lemon56789/delta_robot_proj/README.md

# Delta Robot with Virtual Sensing

## 📌 프로젝트 개요
저가형 델타 로봇의 하드웨어 한계를 **가상 센싱 기술**과 **모델 기반 보정**을 통해 극복하는 것을 목표로 한다.

- 저가 모터 + 3D 프린팅 프레임 사용
- 시뮬레이션 기반 디지털 트윈 구축
- 가상 센싱을 통한 정밀도 보정

---

## 🎯 목표
- 시뮬레이션 결과와 실제 로봇 동작을 최대한 일치시키기
- 센서 없이도 높은 위치 정확도 확보
- 저가 하드웨어의 한계 극복

---

## 🧠 핵심 기술
- Delta Robot Inverse Kinematics
- Multibody Dynamics (RecurDyn)
- Structural Analysis (Nastran)
- Simscape 기반 Digital Twin
- Virtual Sensing (AI + Physics Hybrid)

---

## 🧩 시스템 구조
```mermaid
flowchart LR
    A[Target Trajectory] --> B[Controller<br/>Arduino]
    B --> C[Real Robot<br/>Hardware]
    C --> D[Measured Data]
    D --> E[Virtual Sensor<br/>AI Model]
    E --> F[Correction Value]
    F --> G[Feedback to Controller]
    G --> B
```

---

## 🛠️ 사용 툴
- MATLAB / Simulink / Simscape
- RecurDyn
- Nastran
- Arduino
- PyTorch (future optional)
- Unity (optional)
- GitHub

---

## 👥 팀원 역할

| 팀원 | 역할 |
|---|---|
| S | 팀장, 하드웨어 제작/조립, 기획 단계 동역학/진동 분석 |
| L | 시스템 통합, 가상센싱, 데이터 처리/학습 |
| Y | Arduino 제어, 회로 구성/배선, 전원 연결 |
| T | 하드웨어 제작/조립, 기구 설계 |
| N | 하드웨어 제작/조립, 프로파일 주문제작 요청, 기획 단계 구조/응력 해석 |

---

## 📂 폴더 구조

delta-robot-virtual-sensing/
├─ docs/
├─ kinematics/
├─ simulation/
├─ hardware/
├─ cad/
├─ data/
│  └─ vision/
│     └─ raw/
├─ control/
├─ virtual_sensor/
└─ experiments/

---

## 🚀 진행 단계

상세 실행 계획과 현재 우선순위는 `docs/roadmap.md`를 기준으로 관리한다.

```mermaid
flowchart LR
    subgraph A["1. 설계"]
        A0["Status: Planned"]
        A1["[ ] 기구 규격 정의"]
        A2["[ ] 역기구학 수식 정리"]
        A3["[ ] 모터 및 재료 선정"]
    end

    subgraph B["2. 시뮬레이션"]
        B0["Status: Planned"]
        B1["[ ] 구조 해석"]
        B2["[ ] 동역학 해석"]
        B3["[ ] 디지털 트윈 구축"]
    end

    subgraph C["3. 제작"]
        C0["Status: Planned"]
        C1["[ ] 3D 프린팅 및 조립"]
        C2["[ ] 아두이노 제어 구현"]
    end

    subgraph D["4. 가상센싱"]
        D0["Status: Planned"]
        D1["[ ] 데이터 비교 및 학습"]
        D2["[ ] 오차 보정"]
    end

    subgraph E["5. 검증"]
        E0["Status: Planned"]
        E1["[ ] 궤적 오차 분석"]
        E2["[ ] 시스템 신뢰성 평가"]
    end

    A --> B --> C --> D --> E
```

진행 현황은 아래 체크박스로 바로 갱신할 수 있습니다.

- [ ] 1단계 설계 완료
- [ ] 2단계 시뮬레이션 완료
- [ ] 3단계 제작 완료
- [ ] 4단계 가상센싱 완료
- [ ] 5단계 검증 완료

### 1단계: 설계
- 기구 규격 정의
- 역기구학 수식 정리
- 모터 및 재료 선정

### 2단계: 시뮬레이션
- 구조 해석
- 동역학 해석
- 디지털 트윈 구축

### 3단계: 제작
- 3D 프린팅 및 조립
- 아두이노 제어 구현

### 4단계: 가상센싱
- 데이터 비교 및 학습
- 오차 보정

초기 학습 및 검증 단계에서는 외부 비전 기반 `XY ground-truth` 측정계를 사용해 엔드이펙터의 실제 위치 기준값을 확보할 수 있다. 운영 단계에서는 해당 외부 측정계를 제거하고, 모터 각도 실측값과 시뮬레이션 데이터를 활용한 가상센싱 기반 보정만 사용한다.

### 5단계: 검증
- 궤적 오차 분석
- 시스템 신뢰성 평가
