lemon56789/delta_robot_proj/hardware/README.md

# hardware

실물 하드웨어 제작, 배선, BOM, 조립 관련 자료를 관리하는 폴더입니다.
