lemon56789/delta_robot_proj/cad/README.md

# cad

기구 설계용 CAD 모델(STEP/STL 포함)을 관리하는 폴더입니다.
