lemon56789/delta_robot_proj/control/README.md

# control

Arduino 제어 로직과 제어 파라미터를 관리하는 폴더입니다.
