lemon56789/delta_robot_proj/fulltext.md

# Delta Robot Virtual Sensing - Full Context

문서 목적: 외부 AI 모델이 이 리포지토리를 빠르게 이해하고, 분석/코드 지원을 수행할 수 있도록 프로젝트 전반을 한 파일로 요약한다.
갱신일: 2026-06-10

주의: 이 파일은 요약본이다. 상충 시 Source of Truth는 `docs/*` -> `AGENTS.md` -> `README.md` -> 코드 순서를 따른다.

## 1) 프로젝트 개요
이 프로젝트는 저가형 델타 로봇의 하드웨어 한계를 가상 센싱(Virtual Sensing)과 모델 기반 보정으로 보완해 위치 정밀도를 높이는 것을 목표로 한다.

핵심 접근:
- 저가 모터와 3D 프린팅 기반 하드웨어를 사용한다.
- Simscape 중심의 시뮬레이션 경로를 구축한다.
- 실제 로봇 로그, 시뮬레이션 데이터, 외부 ground-truth, AI 기반 가상센서를 연결한다.
- 최종 운영 단계에서는 외부 비전 측정계를 제거하고, 모터 명령/실측 각도/시뮬레이션 데이터 기반 보정만 사용한다.

## 2) 현재 시스템 흐름
기본 시스템 흐름은 아래와 같다.

```text
Target Trajectory
-> Inverse Kinematics
-> Arduino Controller
-> Delta Robot Hardware
-> Measured Data
-> Simulation Data
-> Virtual Sensor
-> Correction
-> Feedback Controller
```

의도:
- 목표 위치를 IK로 `theta*_cmd`로 변환한다.
- 실제 로봇에서 `theta*_meas`와 위치 오차 관련 데이터를 수집한다.
- Simscape 결과와 실제 로그를 시간축 기준으로 정렬한다.
- 가상센서가 위치 오차 또는 보정값을 추정한다.
- 보정값은 현재 정책상 `target_position`에 주입한다.

## 3) 주요 폴더 역할
- `docs/`: 프로젝트 문서, 시스템 설계, 운동학 메모, 비전 측정계 문서, measured data 구조 문서, 로드맵
- `docs/plans/`: 작업 전 승인용 계획서
- `docs/daily_notes/`: 날짜별 변경 기록
- `docs/templates/`: 계획서와 Daily Note 템플릿
- `docs/references/`: 참고 논문 및 외부 자료 보관 경로. SoT나 채택안을 의미하지 않는다.
- `docs/workspace_envelope.md`: 설치 높이와 `XY` 작업공간 관계를 정리한 설계 참고 문서
- `docs/measured_data_structure.md`: real main log, vision raw log, angle-derived measured position, processed merged dataset 구조
- `docs/hardware_experiment_index.md`: 하드웨어 실험 문서 인덱스
- `docs/hardware_experiment_base_config.md`: 하드웨어/제어/전원/비전/로그 공통 설정
- `docs/hardware_experiment_run_*.md`: 커미셔닝, baseline 수집, 보정 비교, 최종 시연용 run protocol
- `kinematics/`: 역기구학/순기구학 구현, 왕복 검증 및 workspace 분석
- `simulation/`: RecurDyn, Nastran, Simscape 기반 시뮬레이션 자산
- `hardware/`: 실물 제작, 배선, BOM, 조립 자료
- `control/`: Arduino 제어 로직 및 파라미터
- `virtual_sensor/`: 가상 센서 학습/추론 코드
- `data/`: 실험/시뮬레이션 원본 및 가공 데이터
- `data/real/raw/`: Run 01/02 main, correction, metadata, serial raw
  artifact 저장 경로
- `data/real/derived/`: angle-derived measured position CSV 저장 경로
- `data/vision/raw/`: 비전 기반 raw ground-truth 로그 저장 기준 경로
- `data/vision/calibration/`: calibration/homography artifact 저장 경로
- `data/simulation/raw/`: Simscape raw output CSV 저장 경로
- `data/processed/`: processed merged dataset 저장 경로
- `cad/`: CAD 모델
- `experiments/`: 실험 계획, 로그, 성능 검증 자료

## 3-A) 팀 역할 요약
- S: 팀장, 하드웨어 제작/조립, 실험 진행 지원, 기획 단계 동역학/진동 분석
- L: 시스템 통합, 가상센싱, 데이터 처리/학습, 비전 기반 측정
- Y: Arduino 제어, 회로 구성/배선, 전원 및 구동계 연결
- T: 하드웨어 제작/조립, 기구 설계, 제작 치수 검토
- N: 하드웨어 제작/조립, 프로파일 주문제작 요청, 기획 단계 구조/응력 해석
- 동역학/진동/구조/응력 해석은 기획 단계 역할로 유지하되, 시간 제약상 실제 주 산출물은 Run 00/Run 01-pre 하드웨어 제작, 조립, 회로/배선, 데이터 파이프라인 검증 중심으로 정리한다.

## 4) 좌표계와 단위
현재 기준 문서: `docs/system_data_flow.md`

기본 정의:
- position unit: `mm`
- angle unit: `deg`
- coordinate frame: `base_frame`
- origin: base center `O`
- `+x`: `B1` 방향에서 반시계 90도 회전한 방향
- `+y`: `O -> B1`의 반대 방향
- `+z`: base에서 바깥으로 나오는 방향
- workspace direction: `-z`
- right-hand rule: 사용

기구 변수:
- `sB`: base 정삼각형 변 길이
- `sP`: platform 정삼각형 변 길이
- `uB`: base 중심에서 꼭짓점까지의 거리
- `uP`: platform 중심에서 꼭짓점까지의 거리
- `wB`: base 중심에서 motor/upper-arm joint 기준점까지의 거리
- `wP`: platform 중심에서 변까지의 거리
- `L`: motor-driven upper arm length
- `l`: parallelogram link length
- `B1`, `B2`, `B3`: 각 motor/base side center
- `P1`, `P2`, `P3`: 각 platform 연결점

현재 nominal geometry parameter:
- `L = 125.0 mm`
- `l = 300.0 mm`
- `wB = 46.0 mm`
- `uP = 27.177 mm`

현재 하드웨어 참고 치수:
- `sB = 199 mm`: base 외곽 정삼각형 변 길이이며 IK/FK 기준값이 아니다.
- `sP = 57.5 mm`: platform 외곽 정삼각형 변 길이이며 IK/FK 기준값이 아니다.
- `H = 285 mm`: base origin/base center O에서 ground plane까지의 설치 높이다.
- 기구학 계산에서는 외곽 치수보다 `wB`, `uP`를 우선한다.

## 5) 데이터 계약과 시간 정책
현재 기준 문서: `docs/system_data_flow.md`, `docs/measured_data_structure.md`

Timestamp:
- field name: `time`
- format: `boot_ms`
- resolution: `ms`
- Arduino와 PC logger가 각각 timestamp를 기록한다.
- 이후 `post-alignment`로 정렬한다.
- 누락 timestamp row는 `invalid`로 표기하고 후처리에서 제외한다.

현재 final processed CSV 고정 컬럼 순서:
1. `time`
2. `target_x`
3. `target_y`
4. `target_z`
5. `theta1_cmd`
6. `theta2_cmd`
7. `theta3_cmd`
8. `theta1_meas`
9. `theta2_meas`
10. `theta3_meas`
11. `sim_x`
12. `sim_y`
13. `sim_z`
14. `error_x`
15. `error_y`
16. `error_z`

중요:
- 기존 초기 예시의 `motor*_cmd`, `motor*_meas` 대신 현재 문서에서는 `theta*_cmd`, `theta*_meas`를 사용한다.
- correction 관련 필드는 `corr_*`가 아니라 `error_*`를 사용한다.
- CSV 구조 변경은 Contract Change로 취급한다.
- 위 16개 컬럼은 raw log가 아니라 학습/평가용 processed merged dataset의 fixed column order다.
- real main log, vision raw log, angle-derived measured position은 별도 raw/auxiliary 계층으로 관리한다.
- contract-compliant `error_*`는 measured data, simulation output, vision data가 post-alignment된 processed merged dataset 단계에서만 생성한다.

Measured data 계층:
- Real main log: `data/real/raw/main_<run_id>.csv`에 `run_id`, `time`, `target_*`, `theta*_cmd`, `theta*_meas`, `valid`를 기록한다.
- Vision raw log: `data/vision/raw/vision_<run_id>.csv`에 `run_id`, `vision_time`, `vision_x`, `vision_y`, `marker_detected`, `frame_id`, `valid`를 기록한다.
- Simscape raw output: `data/simulation/raw/simscape_<run_id>.csv`에 `time`, `sim_x`, `sim_y`, `sim_z`를 기록한다.
- Angle-derived measured position: `data/real/derived/measured_position_<run_id>.csv`에 `theta*_meas` 기반 FK 또는 estimator로 `measured_x_est`, `measured_y_est`, `measured_z_est`를 생성한다.
- Processed merged dataset: `data/processed/merged_<run_id>.csv`에 real main log, Simscape output, vision raw log, angle-derived measured position을 정렬해 16개 final CSV 컬럼을 만든다.

`error_*` 생성 기준:
- `error_x = measured_x_vision - sim_x`
- `error_y = measured_y_vision - sim_y`
- `error_z = measured_z_est - sim_z`
- `error_x/y`는 vision 기반 XY ground-truth에서 생성한다.
- `error_z`는 angle-derived estimate 기반이므로 외부 ground-truth 기반 3D 성능 수치로 해석하지 않는다.

## 6) 인터페이스 계약
IK:
- input order: `target_x`, `target_y`, `target_z`
- output order: `theta1_cmd`, `theta2_cmd`, `theta3_cmd`
- position 기준: `base_frame`, `mm`
- angle 기준: `deg`
- fail behavior: `reject`

Simulation:
- primary source: `Simscape`
- input: `target_x`, `target_y`, `target_z`
- output: `sim_x`, `sim_y`, `sim_z`
- `RecurDyn` 결과는 추후 cross-check용 secondary reference가 될 수 있다.

Alignment:
- 기준 clock: `PC logger`
- resampling: `linear interpolation`
- delay compensation: `post-alignment`
- 현재 fake pipeline 기준 `Simscape` 비교에서는 provisional `1 sample = 20 ms` lag 보정을 사용한다.
- Run 01-pre preprocessing에서는 vision 로그 시작 시각을 main 첫 timestamp에 맞추는 provisional relative-time alignment를 사용했다.
- `invalid` row는 alignment와 비교에서 제외한다.

Correction:
- correction target: `target_position`
- correction fields: `error_x`, `error_y`, `error_z`
- correction unavailable fallback: uncorrected target position 사용
- SoT 의미는 `measured_position - sim_position`이며, 현재 `Simscape` CSV의 `target_position - sim_position` 값은 임시 diagnostic으로만 해석한다.
- `error_*`는 raw Simscape export에서 확정하지 않고, measured data 구조가 정렬된 processed merged dataset 단계에서 생성한다.
- 현재 Run 02 실행값은 XY gain `0.25`, XY vector norm clamp `2 mm`,
  Z correction off다.
- 현재 제어 분류는 encoder feedback closed loop가 아니라
  `theta*_meas=command_echo_no_encoder` 기반 PC-side feedforward
  correction이다.

## 7) 비전 기반 Ground-Truth 측정계
현재 기준 문서: `docs/vision_tracking.md`

역할:
- 운영 센서가 아니다.
- 학습 및 검증 단계에서만 사용하는 외부 `XY ground-truth` 측정계다.
- 최종 운영 경로는 `motor command + measured motor angle + simulation data + virtual sensing` 기준을 유지한다.

구성:
- top-view USB webcam
- ArUco marker 우선
- OpenCV 기반 marker detection
- calibration, lens distortion correction, planar homography 적용
- 좌표 결과는 `base_frame` 기준 `mm`로 변환

범위:
- 단일 top-view webcam 기준으로 `XY` 위치를 측정한다.
- `Z` 위치는 직접 ground-truth로 제공하지 않는다.
- 비전 로그는 메인 CSV 필수 컬럼에 직접 편입하지 않는다.
- timestamp 기준 후처리로 메인 로그와 병합한다.

비전 로그 저장 기준:
- 기본 경로: `data/vision/raw/`
- 최소 파일명 규칙: `vision_<run_id>.csv`
- 최소 필드: `run_id`, `vision_time`, `vision_x`, `vision_y`, `marker_detected`, `frame_id`, `valid`
- 선택 필드: `marker_id`, `reprojection_error`, `confidence`, `video_file`

Run 00에서 vision system은 marker 검출뿐 아니라 좌표계 방향 확인에도 사용한다.
- 정지 상태에서 `vision_x/y`가 `base_frame` 기준 mm 좌표로 안정적으로 기록되는지 확인한다.
- 작은 +x/+y 수동 이동을 만들었을 때 vision 좌표 증가 방향이 SoT 좌표계와 일치해야 한다.
- 초기 motor direction/zeroing 확인 단계에서 marker loss는 hard stop은 아니지만, vision 위치 확인 단계에서 `1 s` 이상 marker가 연속 미검출되거나 좌표 방향이 반대이면 해당 run은 invalid로 표시하고 trajectory test로 넘어가지 않는다.

WSL/Windows 비전 실행 방침:
- repo의 Source of Truth는 WSL의 `/home/lemon56789/delta_robot`에 둔다.
- Windows 환경은 C-pre camera I/O 실행에만 사용한다. repo 전체를 Windows로 복제하지 않는다.
- WSL에서 webcam이 `/dev/video*`로 노출되지 않을 수 있으므로, C-pre에서는 Windows Python에서 OpenCV를 실행하는 방식을 우선한다.
- Windows Python에서 `opencv-contrib-python`과 `numpy`를 설치한 뒤 camera open, ArUco ID detection, platform marker pixel CSV 저장을 확인한다.
- C-pre pixel log는 homography 전 사전 점검용이며, Run 00 C 최종 `vision_x/y` mm 로그와 구분한다.
- C-pre pixel CSV 권장 컬럼:
  - `run_id`
  - `vision_time`
  - `frame_id`
  - `marker_id`
  - `marker_px`
  - `marker_py`
  - `marker_detected`
  - `valid`
- C-pre pixel CSV 권장 파일명: `data/vision/raw/vision_pixel_<run_id>.csv`
- Windows에서 WSL repo에 바로 저장할 경우 예시 경로:
  - `\\wsl$\<distro>\home\lemon56789\delta_robot\data\vision\raw`
  - `<distro>` 이름은 PowerShell의 `wsl -l -v`로 확인한다.
- `\\wsl$` 경로 저장이 느리거나 권한 문제가 있으면 Windows 임시 경로에 저장한 뒤 WSL repo로 복사한다.

## 8) IK 구조 정리 상태
현재 기준 문서: `docs/ik_structure_note.md`

문서 성격:
- 구현 채택안 자체라기보다, `2atan(t)` 기반 IK를 프로젝트 변수로 해석하기 위한 reference 메모다.
- 현재는 문서 기준 수식 구조와 branch 선택 규칙이 정리되어 있고, 이를 따르는 최소 Python 구현이 추가되어 있다.

`theta_i` 정의:
- `theta_i`는 arm `i`의 local actuation plane에서 정의되는 upper arm 회전각이다.
- `theta_i = 0 deg`: upper arm이 `base plane`에 놓인 자세
- `theta_i = +90 deg`: upper arm이 workspace direction인 `-z`와 평행한 자세
- 양의 방향: upper arm이 base plane에서 workspace 방향으로 내려가는 회전 방향

핵심 IK 흐름:
1. 입력 `(x, y, z)`를 `base_frame` 기준 `mm`로 받는다.
2. 각 arm의 `B_i`, `P_i`, `J_i(theta_i)`를 정의한다.
3. 길이 제약식 `|P_i - J_i(theta_i)|^2 = l^2`를 둔다.
4. 각 arm에 대해 `E_i cos(theta_i) + F_i sin(theta_i) + G_i = 0` 형태로 정리한다.
5. `t_i = tan(theta_i / 2)` 치환을 적용한다.
6. `t_i`에 대한 2차식 해를 구한다.
7. `theta_i = 2 atan(t_i)`로 각도를 복원한다.
8. 판별식, 임시 각도 범위, downward-working branch, 이전 각도 연속성 기준으로 root를 선택한다.

arm outward unit vector:
- `e_1 = (0, -1)`
- `e_2 = ((sqrt(3) / 2), (1 / 2))`
- `e_3 = (-(sqrt(3) / 2), (1 / 2))`

대표 좌표식:
- `B_i = wB e_i`
- `P_i = (x, y) + uP e_i`
- `J_i(theta_i) = (wB + L cos(theta_i)) e_i + (-L sin(theta_i)) k`

arm 1 예시:
- `P_1 = (x, y - uP, z)`
- `J_1(theta_1) = (0, -wB - L cos(theta_1), -L sin(theta_1))`
- `E_1 = 2 L (y - uP + wB)`
- `F_1 = 2 L z`
- `G_1 = x^2 + (y - uP + wB)^2 + z^2 + L^2 - l^2`

일반화:
- `r = (x, y)`
- `p_i = r · e_i`
- `E_i = -2 L (p_i + uP - wB)`
- `F_i = 2 L z`
- `G_i = x^2 + y^2 + (uP - wB)^2 + 2 (uP - wB) p_i + z^2 + L^2 - l^2`

반각 해:
- `t_i = (-F_i ± sqrt(E_i^2 + F_i^2 - G_i^2)) / (G_i - E_i)`
- `theta_i = 2 atan(t_i)`

root selection:
- 판별식 `E_i^2 + F_i^2 - G_i^2 < 0`이면 reject
- 현재 hardware-safe provisional range는 `-45 deg <= theta_i <= 90 deg`
- downward-working branch에 속하는 해만 유효 후보로 둔다.
- 후보가 둘이면 `previous_theta_i`와 가장 가까운 해를 선택한다.
- 후보가 없으면 reject한다.

남은 IK/하드웨어 연결 관련 미정 항목:
- 실제 하드웨어 반복 구동 후 hardware-confirmed `theta_min`, `theta_max` 확정
- Run 00에서 arm별 `center_cmd_i`, `sign_i`, `fine_offset_i` 재확인
- FK 기반 역검증 절차

현재 코드 상태:
- `kinematics/geometry.py`에 `DeltaGeometry` dataclass와 `NOMINAL_DELTA_GEOMETRY`가 정의되어 있다.
- `kinematics/inverse_kinematics.py`에 `delta_ik(x_mm, y_mm, z_mm)`가 구현되어 있다.
- 구현은 각 arm별 일반화된 `E_i`, `F_i`, `G_i` 식, 판별식 기반 reject, 임시 각도 범위, `previous_theta_deg` 기반 해 선택을 사용한다.
- 현재 구현은 `theta_i = 2 atan(t_i)`와 `J_i/FK z = -L sin(theta_i)` 정의를 문서 SoT와 같은 부호 체계로 사용한다.
- 간단한 sample point에 대해 실제 각도 계산이 수행되는 최소 실행 검증은 완료되었다.
- 현재 nominal-analysis candidate range와 hardware-safe provisional range는 모두 `-45 deg <= theta_i <= 90 deg`로 관리하고, hardware-confirmed range는 별도 미확정 상태로 둔다.

## 9) 하드웨어 실험 준비 상태
현재 기준 문서: `docs/hardware_experiment_base_config.md`, `docs/hardware_experiment_run_00_commissioning.md`

Run 00 상태:
- Run 00은 데이터 수집 실험이 아니라 실제 장비 커미셔닝 실험이다.
- 목적은 전원, Arduino 명령, motor 방향, zeroing 기준, 안전 중지 조건, 기본 로그, vision 위치 확인이 SoT 기준과 일치하는지 검증하는 것이다.
- 2026-06-05 기준 Run 00 A/B/C gate는 통과 상태로 정리되었다.
- Run 01 baseline data collection으로 넘어갈 수 있는 최소 gate는 통과했지만, Run 01부터는 main/vision/simscape/processed artifact와 metadata를 run별로 검증해야 한다.

전원과 안전:
- servo 전원은 2S Li-Po battery 기준 공칭 `7.4 V`, 완충 `8.4 V`이며 servo 입력은 `8.4 V`를 초과하지 않는다.
- pump 전원은 `12 V DC supply`, Arduino logic 전원은 PC USB `5 V`다.
- 현재 dedicated fuse와 software `STOP` command는 미구현이다.
- Run 00에서는 Y가 power cutoff operator로 참석하고, 이상 동작 시 Li-Po servo power를 물리적으로 차단하는 방식을 우선한다.
- absolute no-go pose는 `theta_i <= -65 deg` 또는 `theta_i >= +90 deg`다.

Arduino command mapping:
- 입력 command는 raw servo angle이 아니라 SoT 기준 `theta_cmd` [deg]다.
- 기본 변환식은
  `servo_angle_i = center_cmd_i + sign_i * theta_cmd_i * theta_gain_i + fine_offset_i`다.
- 현재 기록값:
  - `center_cmd_1 = 84 deg`
  - `center_cmd_2 = 86 deg`
  - `center_cmd_3 = 88 deg`
  - base config 문서 기록: `sign_i = +1`
  - `fine_offset_i = 0 deg`
- 실제 Run 02에 사용한
  `control/pick_place_state_machine_GRID.ino`의 effective mapping은
  `sign_i = -1`, `theta_gain_i = 1.25`이며 최종
  `servo.write()` 전에 integer servo angle로 반올림한다.
- 따라서 base config의 sign 기록과 Run 02 firmware effective mapping은
  후속 문서 정합성 확인이 필요하다. Run 02 actuator 분석은 실제 firmware
  mapping을 기준으로 수행했다.
- `center_cmd_i`는 SoT 기준 `theta_i = 0 deg`가 실제 servo command angle 몇 도에 해당하는지 나타내는 값이다.
- 현재 실행 firmware는 `control/pick_place_state_machine_GRID.ino`이며
  보조 시험 firmware로 `control/motor_test_IK.ino`가 있다.

Run 00 기본 확인 순서:
- 모든 arm을 `theta_i = 0 deg`에서 시작한다.
- A 단계에서는 조립 상태에서 각 motor에 대해 단일축 `0 -> +3 -> 0 -> -3 -> 0 deg`를 먼저 확인하고, 통과하면 `+/-5 deg`로 확장한다.
- B 단계에서는 IK 기반 target command로 `x/y` 방향 `+/-3 mm` 이동을 확인하고, 통과하면 `+/-5 mm`로 확장한다. 실제 좌표 정확도는 평가하지 않는다.
- C 단계에서는 B와 같은 작은 x/y 이동을 vision logger로 읽어 marker 검출, `vision_x/y` 좌표 방향, static noise, 같은 `run_id` 여부를 확인한다.
- A가 실패하면 B로 가지 않고, B가 실패하면 C로 가지 않는다.

Run 01-pre 상태:
- Run 01-pre는 final training dataset이 아니라 raw log, Simscape output, alignment, merge, `error_*` label 생성이 end-to-end로 동작하는지 확인하는 pipeline validation 단계다.
- 2026-06-06 기준 static/cross/square Run 01-pre pipeline validation은 완료되었다.
- 확보된 산출물:
  - `data/real/raw/main_2026-06-05_run01_pre_*.csv`
  - `data/vision/raw/vision_2026-06-05_run01_pre_*.csv`
  - `data/simulation/raw/simscape_2026-06-05_run01_pre_*.csv`
  - `data/real/derived/measured_position_2026-06-05_run01_pre_*.csv`
  - `data/processed/merged_2026-06-05_run01_pre_*.csv`
- `virtual_sensor/check_dataset.py` 검증에서 static/cross/square merged CSV 모두 16-column shape와 `has_nan=False`를 확인했다.
- 한계: cross marker/valid ratio는 약 `92.98%`, square는 약 `93.21%`였고, 현재 `theta*_meas`는 실제 encoder가 아니라 `command_echo_no_encoder`다. 따라서 Run 01-pre artifact는 최종 학습 데이터가 아니다.

Run 01-main 및 holdout 상태:
- Run 01-main은 static center, cross `±40 mm`, square `±40 mm`, circle
  `r=40 mm`, grid `3x3 ±40 mm`를 각각 3회 수행한 총 15개 run이다.
- Run 01-main 15개는 trajectory-aware alignment와 phase-boundary
  realignment를 거쳐 총 `5,158` processed row로 확정되었다.
- complete holdout은 static center, cross `±30 mm`, square `±30 mm`,
  grid `3x3 ±40 mm` 4개이며 fitting과 tuning에서 제외했다.
- cross/square/grid는 stable position에서 `5 mm` departure event를
  검출해 main phase boundary와 대응시킨다. 이 수정으로 다음 setpoint
  이동이 이전 phase 끝에 포함되던 alignment 오류를 제거했다.
- processed dataset은 fixed 16-column schema, finite value, strictly
  increasing timestamp와 `has_nan=False` 검증을 통과했다.

Run 01 Ridge 가상센서:
- 첫 모델은 NumPy 기반 standardized Ridge regression이다.
- feature는 `theta*_cmd`, `theta*_meas`, `sim_x/y/z`, target은
  `error_x/y/z`다.
- repetition 단위 run-level 3-fold CV로 alpha를 선택하고 main 15개
  전체로 최종 모델을 재학습했다.
- 최종 모델:
  `virtual_sensor/models/ridge_run01_main_2026-06-06.npz`
- 선택 alpha: `100`
- main OOF macro XY RMSE: `4.887 mm`
- complete holdout 4개 macro XY RMSE:
  - zero prediction: `4.533 mm`
  - Ridge: `2.848 mm`
  - improvement: `37.174%`
- holdout run별 개선율은 static `43.427%`, cross `16.933%`, square
  `36.110%`, grid `45.895%`다.
- holdout alignment 결함을 진단하고 수정한 뒤 얻은 retrospective
  결과이므로 fresh Run 02를 독립 성능 gate로 사용했다.

Run 02 correction 비교:
- 실행일은 `2026-06-07`이며 기존 준비 식별자와의 연속성을 위해 raw
  run ID의 날짜 문자열은 `2026-06-06`을 유지했다.
- trajectory는 cross `±30 mm`, reverse grid `3x3 ±40 mm`, diamond
  `±35 mm`, circle `r=40 mm`다.
- 각 trajectory에서 OFF/ON을 repetition별 3회 수행해 총 24개 run,
  12개 paired comparison을 확보했다.
- correction 설정은 gain `0.25`, XY clamp `2 mm`, Z correction off다.
- generated artifact:
  - measured-position CSV 24개
  - fixed 16-column merged CSV 24개
  - alignment sidecar JSON 24개
  - comparison report 1개
- 공식 trajectory별 `tracking_xy_rmse` 3회 평균이다. 표의
  `improvement`는 repetition별 개선율을 계산한 뒤 3회 평균한 값이다.

| trajectory | OFF mean | ON mean | improvement | improved pairs |
|---|---:|---:|---:|---:|
| cross | `5.6003 mm` | `5.9854 mm` | `-7.73%` | `1/3` |
| reverse grid | `7.9846 mm` | `7.0663 mm` | `+11.05%` | `3/3` |
| diamond | `5.6410 mm` | `4.8702 mm` | `+13.67%` | `3/3` |
| circle | `6.2069 mm` | `7.7670 mm` | `-25.41%` | `0/3` |

- 네 trajectory 동일가중 공식 결과는 OFF `6.3582 mm`, ON
  `6.4222 mm`다. 평균 RMSE를 직접 비교하면 `1.01%` 악화이며,
  repetition별 개선율을 먼저 계산해 평균하면 `2.10%` 악화다. 어느
  정의에서도 전체 개선으로 판단하지 않았다.
- 모델 predicted error와 OFF 실제 tracking error 방향은
  `95.6~100%` 일치해 correction sign 자체는 정상으로 판단했다.

Run 02 기존 데이터 재분석:
- 구현: `experiments/run02_reanalyze.py`
- 결과:
  `experiments/results/run02_reanalysis_2026-06-07.json`
- 12개 absolute RMSE는 공식 comparison report와 차이 `0`으로
  재현됐다.
- 각 run 초기 `home_1`의 `vision-target` 중앙값을 제거한
  home-normalized 결과:

| trajectory | OFF mean | ON mean | improvement | improved pairs |
|---|---:|---:|---:|---:|
| cross | `4.2138 mm` | `5.1725 mm` | `-22.75%` | `1/3` |
| reverse grid | `7.1461 mm` | `6.9019 mm` | `+3.42%` | `3/3` |
| diamond | `4.8680 mm` | `4.1399 mm` | `+14.96%` | `3/3` |
| circle | `5.4864 mm` | `7.3527 mm` | `-34.02%` | `0/3` |

- Diamond만 absolute와 home-normalized에서 모두 세 repetition 개선됐다.
- main CSV의 실제 전송 theta를 Arduino integer servo mapping으로
  변환했을 때 nominal command와 달라진 비율:
  - cross `11.1%`
  - reverse grid `45.5%`
  - diamond `27.1%`
  - circle `33.0%`
- cross에서는 correction 대부분이 실제 integer actuator command
  변화로 이어지지 않아 actuator resolution 제한이 크다.
- Diamond는 transition/stable의 absolute와 normalized 네 조건에서
  모두 개선됐다.
- Circle은 radial RMSE가 `3.319 -> 2.843 mm`로 감소했지만 tangential
  RMSE가 `3.593 -> 4.442 mm`, 평균 tangential error가
  `0.048 -> 3.037 mm`로 증가했다.
- Circle equivalent median phase lag는 OFF `2.2 ms`, ON `361.7 ms`였고
  ON 세 repetition의 diagnostic best shift는 모두 `350 ms`였다.
- best-shift RMSE는 OFF `4.791 mm`, ON `4.220 mm`지만 실제 동적 lag를
  제거하는 diagnostic이므로 공식 time-domain metric을 대체하지 않는다.

최소 home repeatability 후속 실험 준비:
- +X 이동은 -X 이동보다 부하와 진동이 큰 것으로 관찰됐다.
- `(+60, 0)`에서 home으로 복귀하면 원점에 더 가까워지는 경향이
  관찰되어, 동일 방향 접근 효과를 최소 실험으로 확인하기로 했다.
- 확정 run ID:
  - `2026-06-07_home_repeat_xp40_r01-r03`
  - `2026-06-07_home_repeat_xp60_r01-r03`
- 공통 순서는 `+X preload -> 2 s hold -> home -> 5 s stabilization`이다.
- xp40 세 run을 먼저 수행하고 안전 확인 후 xp60으로 진행한다.
- Computer 2 Codex 인수인계:
  `experiments/home_repeatability_computer2_codex_handoff.md`
- Windows Vision Codex 인수인계:
  `experiments/home_repeatability_vision_windows_codex_handoff.md`
- 두 컴퓨터는 같은 run ID와 `VISION READY`/`RUN END` handshake를
  사용한다.
- run별 vision zero 또는 homography 재설정은 실제 home shift를
  제거하므로 금지한다.

## 10) 프로젝트 로드맵
현재 기준 문서: `docs/roadmap.md`

전체 단계:
1. 설계 기준 확정
2. 운동학 정의 및 구현
3. FK 검증 및 기본 해석
4. 시뮬레이션 및 데이터 경로 정리
5. 외부 ground-truth 측정계 구축
6. fake pipeline 구성
7. 실제 데이터 수집
8. 가상센서 학습 및 보정
9. 폐루프 적용 및 성능 검증
10. 외부 측정계 제거 후 운영 검증

현재 상태 요약:
- Stage 1 설계 기준 확정: 완료
- Stage 2 운동학 정의 및 구현: nominal geometry, IK, workspace/angle range 진단까지 1차 완료
- Stage 3 FK 검증 및 기본 해석: FK 최소 구현 및 round-trip/workspace 검증 진행 중
- Stage 4 시뮬레이션 및 데이터 경로 정리: Run 01/02 Simscape 및
  alignment/merge 경로 구현 완료
- Stage 5 외부 ground-truth 측정계 구축: Run 00/01/02 vision XY 수집과
  후처리 검증 완료, home 반복성 품질 확인 예정
- Stage 6 fake pipeline 구성: 최소 경로 완료
- Stage 7 실제 데이터 수집: Run 00 통과, Run 01-pre, Run 01-main,
  holdout 및 Run 02 24개 run 수집 완료
- Stage 8 가상센서 학습 및 보정: Ridge baseline 학습, holdout 평가,
  correction engine 구현 완료
- Stage 9 폐루프 적용 및 성능 검증: PC-side feedforward Run 02 검증 및
  재분석 완료, 전체 개선은 미확인
- Stage 10 외부 측정계 제거 후 운영 검증: 미착수

현재 구현 기준 핵심 상태:
- `kinematics/geometry.py`, `kinematics/inverse_kinematics.py`에 nominal geometry와 IK가 반영되어 있다.
- `kinematics/forward_kinematics.py`, `kinematics/validate_roundtrip.py`, `kinematics/workspace_sweep.py`로 FK, 왕복 검증, workspace sweep이 가능하다.
- `2026-05-25` 기준 `IK/FK`의 `theta` 및 `z` 부호 정의가 문서 SoT와 정렬되었고, representative `IK -> FK` roundtrip 검증이 다시 통과했다.
- 현재 angle range는 `hardware-safe provisional: -45..90 deg`, `nominal-analysis candidate: -45..90 deg`로 관리하고, `hardware-confirmed`는 별도 확정 전 상태로 둔다.
- `docs/workspace_envelope.md`에 설치 높이와 `XY` reachable area 참고 결과가 정리되어 있으며, 현재 기준 추천 설치 높이는 일반적인 pick-and-place 기준 `H = 290 mm`, 대안은 `H = 310 mm`다.
- 실제 현재 hardware base-ground 설치 높이는 `H = 285 mm`로 base config에 기록되어 있고, 이 높이 기준으로 Run 00과 Run 01-pre를 진행했다.
- `experiments/fake_pipeline.py`가 현재 CSV 계약을 따르는 fake dataset CSV/JSON을 생성한다.
- `virtual_sensor/dataset.py`, `virtual_sensor/check_dataset.py`로 fake pipeline CSV를 읽고 feature/target shape와 NaN 여부를 확인할 수 있다.
- `experiments/run01_preprocess.py`가 Run 01 raw main, vision, Simscape CSV를 읽어 angle-derived measured position과 processed merged dataset을 생성한다.
- Run 01-pre static/cross/square processed merged dataset은 생성 및 shape/NaN 검증을 통과했다.
- Run 01-pre artifact는 pipeline validation용이며 final training dataset으로 채택하지 않는다.
- Run 01-main 15개 processed dataset은 phase-boundary realignment 후
  총 `5,158` row이며 Ridge training dataset으로 사용했다.
- 첫 virtual sensor model은 NumPy 기반 standardized Ridge regression으로
  구현되었고 최종 `alpha=100` 모델이 저장되어 있다. PyTorch MLP는
  Ridge baseline보다 명확한 개선 필요성이 확인될 때의 후속 확장이다.
- 초기 모델의 기본 feature는 `theta1_cmd`, `theta2_cmd`, `theta3_cmd`, `theta1_meas`, `theta2_meas`, `theta3_meas`, `sim_x`, `sim_y`, `sim_z`이고 target은 processed merged dataset의 `error_x`, `error_y`, `error_z`다.
- Ridge regularization strength와 feature 선택은 validation split에서만 결정하고, Run 01-holdout은 fitting/tuning에 사용하지 않는다.
- Run 01 complete holdout 4개에서 frozen Ridge macro XY RMSE는
  `4.533 -> 2.848 mm`, `37.174%` 개선됐다.
- `virtual_sensor/correction_engine.py`가 error prediction을 XY target
  correction, vector clamp, corrected-target IK와 nominal fallback으로
  변환한다.
- Run 02는 gain `0.25`, clamp `2 mm`로 24개 fresh hardware run을
  완료했다. 전체 동일가중 absolute XY RMSE는 개선되지 않았지만
  Diamond는 세 pair 모두 일관된 개선을 보였다.
- `experiments/run02_preprocess.py`가 24개 Run 02 merged dataset과 12개
  OFF/ON comparison을 생성한다.
- `experiments/run02_reanalyze.py`가 home normalization, integer servo
  command, step segment와 circle phase diagnostic을 산출한다.
- `wB = 46.0 mm` 기준 Python fake pipeline CSV/JSON과 workspace sweep artifact가 다시 생성되었다.
- Simulink/Simscape에서 새 `sim_*` CSV를 받아 비교한 결과, header/row/time/input field는 일치했고 `sim_*`는 예상대로 약 `1 sample = 20 ms` lag를 보였다.
- 현재 Simscape CSV의 `error_*`는 `target_position - sim_position` diagnostic 값이므로 SoT correction field인 `measured_position - sim_position`으로 직접 사용하지 않는다.
- `docs/measured_data_structure.md`가 추가되어 real main log, vision raw log, angle-derived measured position, processed merged dataset의 네 계층이 정리되었다.
- 초기 `error_x/y`는 vision 기반 XY에서 생성하고, `error_z`는 `theta*_meas` 기반 `measured_z_est`에서 생성한다. `error_z`는 외부 ground-truth 기반 3D 성능 수치로 해석하지 않는다.
- `error_*`는 raw Simscape export가 아니라 processed merged dataset 단계에서 생성한다.
- 하드웨어 실험 문서는 고정 설정 `docs/hardware_experiment_base_config.md`와 실험별 run protocol `docs/hardware_experiment_run_*.md`로 분리되었다.
- base config에는 `wB=46 mm`, `H=285 mm`, 전원 구조, `STOP` 미구현/물리 차단 우선, `center_cmd_i=84/86/88 deg`, Run 00 단계적 theta test range, vision 위치 확인 기준이 반영되었다.
- Run 00 문서는 A/B/C gate 구조로 작성되었고, A/B/C gate는 통과 상태로 정리되었다.
- Run 01 문서는 pre/main/holdout 구조로 작성되었고, main은 training/validation, holdout은 Run 02 comparison baseline으로 분리한다.
- Run 02 공식 비교와 재분석 결과는
  `docs/hardware_experiment_run_02_corrected_comparison.md`,
  `experiments/results/run02_comparison_2026-06-07.json`,
  `experiments/results/run02_reanalysis_2026-06-07.json`에 기록되어 있다.
- 최소 후속 하드웨어 실험은 xp40/xp60 preload 후 home 반복성 6개
  run이며 Computer 2와 Windows Vision Codex용 독립 인수인계 문서가
  준비되어 있다.
- 실제 역할 기준으로 S/T/N은 하드웨어 제작/조립을 수행했고, S는 팀장 역할을 맡았으며, N은 프로파일 주문제작 요청을 담당했다. Y는 Arduino 제어와 함께 회로 구성/배선 및 전원/구동계 연결을 담당했다. L은 시스템 통합, 가상센싱, 데이터 처리/학습, 비전 기반 측정을 담당한다.

## 11) 개발 및 변경 원칙
AGENTS.md 기준 핵심 원칙:
- 변경 전 계획서 작성 및 사용자 승인 필수
- 승인 전 파일 변경 금지
- 어떤 파일이든 수정/추가/삭제하면 `docs/daily_notes/YYYY-MM-DD.md`에 기록
- placeholder/dummy 구현 금지
- 데이터 포맷, 함수 입력/출력, 폴더 구조, 시스템 데이터 흐름 임의 변경 금지
- Contract Change는 명시 승인 필요
- 모든 실험은 실행 커맨드, 사용 데이터, 파라미터, 코드 버전을 기록

## 12) 현재 기술 스택
- Python 3.12.3
- MATLAB / Simulink / Simscape
- Arduino
- PyTorch (future optional)
- OpenCV
- GitHub

## 13) 바로 다음 작업
우선순위:
1. Computer 2와 Windows vision에서 xp40 home repeatability
   `r01-r03`을 수집한다.
2. xp40 세 run이 진동/간섭/stall 없이 끝난 경우에만 xp60
   `r01-r03`을 수집한다.
3. 각 run의 마지막 home stabilization 구간에서 XY 중앙값, X/Y
   표준편차, 반복 간 최대 pairwise 거리와 초기 대비 drift를 계산한다.
4. xp40과 xp60 반복성이 비슷하면 부하가 작은 xp40을 공통 preload로
   선택한다. xp60은 반복성이 더 좋아도 strong vibration 또는 간섭이
   있으면 선택하지 않는다.
5. 선택된 preload를 각 run 전에 독립 적용할 수 있도록 Diamond 최소
   OFF/ON 실행 절차를 확정한다.
6. 시간이 허용되면 Diamond OFF/ON 1 pair를 동일 preload, camera,
   marker, calibration, model, gain과 clamp로 수집한다.
7. 추가 Diamond pair는 absolute/home-normalized 및 transition/stable
   metric으로 기존 Run 02 결과와 비교한다.
8. Cross는 현재 실제 integer command 변화율 `11.1%`이므로 actuator
   resolution 개선 전 재실험 우선순위를 낮게 둔다.
9. Circle은 정적 error correction과 약 `350 ms` 동적 phase lag를
   분리하는 정책이 없으므로 전체 재수집보다 모델/제어 정책 검토를
   우선한다.

BLOCKER 가능성이 있는 항목:
- xp40에서 진동 증가, servo stall, link interference 또는 home 복귀
  실패가 발생하면 xp60을 진행하지 않는다.
- Computer 2 Serial Monitor를 run 사이에 다시 열면 Arduino reset으로
  접근 이력이 바뀌므로 해당 실험 세션을 중단한다.
- vision 기록이 preload 명령 전에 시작되지 않거나 마지막 home
  stabilization `5 s`를 포함하지 않으면 해당 run은 반복성 분석에
  사용할 수 없다.
- run별 vision zero, homography 또는 calibration 재설정은 실제 home
  shift를 제거하므로 금지한다.
- marker가 `1 s` 넘게 연속 소실되면 해당 run은 invalid 후보로
  기록한다.
- 현재 `theta*_meas`가 `command_echo_no_encoder` 상태로 유지되면 `error_z`는 계속 diagnostic으로만 해석해야 한다.
- current servo API가 integer command resolution을 유지하면 작은
  correction은 실제 actuator 변화로 이어지지 않을 수 있다.

## 14) 유지보수 규칙
- 이 파일은 외부 AI 분석용 요약본이다.
- 구조, 규약, 데이터 계약, 로드맵 상태가 바뀌면 함께 갱신한다.
- 상세 근거는 `docs/system_data_flow.md`, `docs/measured_data_structure.md`, `docs/vision_tracking.md`, `docs/ik_structure_note.md`, `docs/workspace_envelope.md`, `docs/roadmap.md`, `AGENTS.md`를 우선 참조한다.
