lemon56789/delta_robot_proj/docs/daily_notes/2026-06-10.md

# Daily Note - 2026-06-10

## Entry 001
- 무엇을: `fulltext.md`와 `docs/roadmap.md`의 현재 상태 및 Run 02 지표
  설명을 정합화했다.
- 왜: `fulltext.md`는 Run 02 완료 상태였지만 상위 Source of Truth인
  `docs/roadmap.md`는 Run 01-main 준비와 Stage 8/9 미착수 상태로 남아
  있었고, Run 02 개선율도 계산 정의에 따라 다른 값이 사용되고 있었기
  때문이다.
- 어떻게: `fulltext.md`의 갱신일과 폴더 설명을 수정하고, trajectory
  표의 개선율이 repetition별 개선율 평균임을 명시했다. 전체 결과에는
  평균 RMSE 직접 비교 `1.01%` 악화와 repetition별 개선율 평균 `2.10%`
  악화를 함께 기록했다. `docs/roadmap.md`의 Stage 4~9 snapshot,
  개별 Current Status, Immediate Priorities와 Open Items를 Run 01-main,
  Ridge 학습, Run 02 수집 및 재분석 완료 상태로 갱신했다.
- 결과: 요약 문서와 로드맵이 같은 프로젝트 상태를 설명하며, Run 02의
  두 개선율 계산 정의가 구분되었다. 전체 trajectory에서 일관된 개선은
  확인되지 않았다는 결론은 유지했다.
- 변경 파일:
  `docs/plans/2026-06-10_001_fulltext_roadmap_consistency.md`,
  `fulltext.md`, `docs/roadmap.md`, `docs/daily_notes/2026-06-10.md`
- 다음: preload 기반 home repeatability를 확인한 뒤 최소 Diamond
  OFF/ON 재검증 여부를 결정한다.
