lemon56789/delta_robot_proj/docs/plans/2026-06-06_019_finalize_run02_24_runs.md

# Plan

## Goal
Finalize the Run 02 experiment as 24 physical runs and implement the
serial-enabled PC logger needed to execute correction OFF/ON under the same
trajectory definitions.

## Files
- `docs/plans/2026-06-06_019_finalize_run02_24_runs.md`
- `experiments/run02_logger.py`
- `experiments/test_run02_logger.py`
- `experiments/run02_logger_computer2_powershell.md`
- `experiments/README.md`
- `docs/hardware_experiment_run_02_corrected_comparison.md`
- `docs/daily_notes/2026-06-06.md`

## Changes
1. Finalize four trajectories:
   - cross `+/-30 mm`;
   - reverse grid 3x3 `+/-40 mm`;
   - diamond `+/-35 mm`, counterclockwise;
   - circle `r=40 mm`, counterclockwise.
2. Finalize the matrix as OFF/ON, three repetitions per trajectory:
   `4 x 2 x 3 = 24` runs.
3. Use a common `target_z=-263.27731514697575 mm`, waypoint hold `5 s`,
   circle `72` points over `30 s`, and `2 s` holds at the circle start/end
   point `(40, 0)`.
   - Record data on a deterministic `0.1 s` schedule.
   - Update serial commands at phase changes or every `0.5 s` to avoid
     backlog in the blocking Arduino smooth-move routine.
4. Use correction gain `0.25`, XY vector clamp `2 mm`, Z correction disabled,
   and the frozen Run 01 Ridge model.
5. Add a serial logger that:
   - builds the finalized trajectory and validates nominal IK;
   - records the existing Run 01-compatible main raw CSV;
   - requires a matching Simscape CSV for correction ON;
   - validates exact schedule/Simscape time-axis equality;
   - computes correction with the existing `CorrectionEngine`;
   - writes a separate auxiliary correction CSV;
   - falls back to nominal target/theta on inference or corrected-IK failure.
6. Add a 24-run manifest command that writes the exact run IDs and expected
   artifact paths without executing hardware.
7. Define run IDs as
   `YYYY-MM-DD_run02_<trajectory>_<off|on>_r01..r03`.
8. Define paired execution order by repetition and trajectory, OFF immediately
   followed by ON, to reduce configuration drift.

## Impact
- Finalizes the Run 02 experiment protocol and adds a new serial logger.
- Does not change the fixed processed 16-column CSV contract.
- Does not change Arduino firmware or the frozen model.
- Adds an auxiliary correction log for Run 02.

## Risk
- Correction ON cannot run without a Simscape CSV generated on the exact
  deterministic schedule.
- `theta*_meas` remains command echo and is not independent encoder feedback.
- PC/serial timing jitter remains possible even though scheduled timestamps are
  deterministic.
- Circle alignment still requires vision-side start/end holds and common event
  handling during post-processing.

## Validation
- Unit-test all four waypoint definitions and circle start/end holds.
- Confirm the manifest contains exactly 24 unique run IDs.
- Confirm OFF/ON pairs share the same nominal schedule.
- Confirm ON rejects missing or mismatched Simscape input.
- Dry-run all four trajectories in OFF and ON mode.
- Confirm correction norm never exceeds `2 mm`, Z correction is zero, and
  theta limits are respected.
- Run Python compile, unit tests, and `git diff --check`.

## Execution Status
- Approved by the user on 2026-06-06.
- Finalized the four trajectories, OFF/ON pairing, three repetitions, run ID
  convention, execution order, and four reusable nominal Simscape paths.
- Implemented deterministic main/correction/serial logging with exact Simscape
  time-axis validation, frozen-model correction, clamp, fallback, and schedule
  lag recording.
- Kept data rows at `0.1 s` and limited serial command updates to phase changes
  or `0.5 s` intervals because the Arduino smooth-move routine is blocking.
- Added unit tests and a Computer 2 PowerShell guide.
- Validation results:
  - `24` unique manifest run IDs and `4` nominal Simscape files;
  - `11` unit tests passed;
  - all four OFF/ON dry-run pairs passed;
  - fallback `0`, clamp `0`;
  - maximum applied correction `1.661925 mm`;
  - corrected theta range across dry-runs approximately
    `-10.968 deg` to `16.187 deg`.
