lemon56789/delta_robot_proj/docs/plans/2026-06-06_016_virtual_sensing_progress_summary.md

# Plan

## Goal
Create one readable project document that summarizes the Run 01 virtual
sensing workflow, implementation decisions, failure analysis, corrected
results, limitations, and next steps without requiring readers to traverse
multiple plans and result files.

## Files
- `docs/plans/2026-06-06_016_virtual_sensing_progress_summary.md`
- `docs/virtual_sensing_progress.md`
- `docs/README.md`
- `virtual_sensor/README.md`
- `docs/daily_notes/2026-06-06.md`

## Changes
- Summarize the virtual sensing objective and data flow.
- Describe Run 01-main/holdout data, feature/target definitions, and validation.
- Explain the initial Ridge result and phase-boundary alignment defect.
- Record the event-anchor realignment and retraining result.
- Compare the original and corrected metrics in one table.
- State current model artifacts, reproducible commands, limitations, and the
  next Run 02 validation gate.
- Link the summary from the docs and virtual sensor indexes.

## Impact
- Documentation only.
- No model, data, interface, controller, or experiment behavior changes.

## Risk
- Metrics can be misunderstood as an unbiased final result. The document must
  explicitly label the corrected holdout result as retrospective because that
  holdout exposed the preprocessing defect.

## Validation
- Cross-check all metrics against current JSON reports.
- Confirm referenced paths exist.
- Confirm links and headings are readable.
- Run `git diff --check`.
