lemon56789/delta_robot_proj/docs/member_profiles/T.md

# T Profile

## Role
하드웨어 제작/조립, 기구 설계, 제작 치수 검토 담당.

## AI Prompt Seed
T는 하드웨어 제작과 기구 설계의 연결 관점에서 답변을 원한다. 구조, 조립성, 제작 치수, 설계 변경 영향과 제어 요구를 함께 고려해서 설명하라.

## Background
- 열전달 및 열유체실습에서 Ansys를 사용해 해석을 진행한 경험이 있다.
- 진동동역학실습 프로젝트에서는 Arduino 프로그래밍을 담당했다.
- 두 수업에서 다룬 프로그램은 어느 정도 활용 가능하다.
- 학부생 연구 프로그램 경험은 아직 없어 해당 부분에서는 상대적으로 부족할 수 있다.
- 현재 기구학 수업을 수강 중이며, 기계 시스템의 구조와 동작에 관심이 있다.
- 선호하는 주제는 기구 설계나 시스템 제어 관련 분야다.

## Scope
- 델타 로봇 기구 구조 설계
- 델타 로봇 하드웨어 제작 및 조립 참여
- 부품 배치, 링크 구조, 조립성 검토
- 제작 치수와 실제 조립 상태 검토
- 제작 가능한 CAD 자산 정리
- 구조와 제어 요구를 함께 고려한 설계 검토

## Primary Directories
- `cad/`
- `hardware/`
- `simulation/`
- `docs/`

## Tools
- Ansys
- Arduino
- CAD 관련 설계 작업 흐름

## Strengths
- 기계 시스템 구조와 동작에 대한 관심이 높음
- 해석 도구와 Arduino 프로그래밍을 모두 다뤄본 경험이 있음
- 실제 하드웨어 제작/조립과 기구 설계 검토를 연결할 수 있음
- 기구 설계와 시스템 제어를 연결해서 볼 수 있음

## Weaknesses Or Cautions
- 학부생 연구 프로그램 경험이 없어 연구 운영이나 문헌 기반 탐색은 단계적으로 지원하는 편이 좋다.
- 현재 정보 기준으로 심화 구조 해석이나 학습 모델링은 핵심 강점으로 보이지 않는다.

## Preferred Topics
- 기구 설계 관련 주제
- 시스템 제어 관련 주제
- 기계 시스템 구조와 동작 분석 주제

## Common AI Support Needs
- 기구 설계 검토 항목 정리
- 조립과 제작 시 고려사항 목록화
- 실제 제작 치수와 문서/모델 기준값 비교
- 설계 변경 영향 범위 파악
- 기구 오차가 시스템 성능에 주는 영향 정리
- 구조와 제어 요구를 함께 만족하는 설계 기준 정리

## Response Priorities
1. 하드웨어 제작/조립 상태와 기구 구조를 먼저 설명한다.
2. 제작 치수, 조립성, 공차 관점의 확인 항목을 포함한다.
3. 설계 변경이 다른 서브시스템에 주는 영향을 함께 정리한다.
4. 필요한 경우 해석 결과와 제어 요구를 연결해 설명한다.

## Related Documents
- `fulltext.md`
- `README.md`
- `AGENTS.md`
