lemon56789/delta_robot_proj/docs/member_profiles/Y.md

# Y Profile

## Role
Arduino 제어, 회로 구성/배선, 전원 및 구동계 연결 담당.

## AI Prompt Seed
Y는 Arduino 기반 제어, 회로 구성/배선, 전원 및 구동계 연결 관점에서 답변을 원한다. 제어 입력과 출력, 배선/전원 연결, 측정값 흐름, 파라미터 조정 절차를 실험 중심으로 설명하라.

## Background
- 자율주행경진대회와 자율주행캡스톤디자인 강의를 수강했다.
- ROS 2를 이용한 자율주행 알고리즘을 공부한 경험이 있다.
- Arduino를 이용한 주행 알고리즘 구현과 실제 주행 테스트에서 파라미터 수정을 담당했다.
- 진동동역학실습에서는 Arduino 프로그래밍 전체를 맡았고, PID 제어를 통해 RPM 제어를 수행했다.
- 미래모빌리티공학, 제어공학기초 수업을 수강해 제어에 대한 기본 지식을 갖추고 있다.
- 학부생 연구 프로그램이나 산학협력 현장실습 경험은 없어 상대적으로 실무형 연구 경험은 적을 수 있다.
- 자율주행과 로봇 관련 주제를 선호하며, 현재 기구학과 로봇공학입문 수업을 수강 중이라 로봇의 동작 제어에 관심이 있다.

## Scope
- 목표 궤적을 모터 명령으로 변환하는 제어 로직 구현
- Arduino, servo, pump, 전원 계통의 회로 구성과 배선
- 전원 및 구동계 연결 상태 확인
- 실기기 제어 흐름과 펌웨어 동작 검토
- 측정 가능한 모터 상태 데이터 확보
- PID 기반 속도 및 동작 제어 조정

## Primary Directories
- `control/`
- `hardware/`
- `experiments/`
- `docs/`

## Tools
- Arduino
- ROS 2
- C/C++ 기반 펌웨어 개발 작업 흐름
- 시리얼 로깅 도구
- 회로 구성 및 배선 작업 흐름

## Strengths
- Arduino 기반 제어 구현과 실제 테스트 파라미터 조정 경험
- 회로 구성/배선과 전원 및 구동계 연결을 실제 제어 테스트와 연결할 수 있음
- PID 제어 및 RPM 제어 경험
- 자율주행 알고리즘과 로봇 동작 제어에 대한 높은 관심

## Weaknesses Or Cautions
- 학부생 연구 프로그램이나 산학협력 현장실습 경험이 없어 장기 연구 운영 경험은 상대적으로 적을 수 있다.
- 고급 모델링이나 해석 중심 질문은 배경 수준을 고려해 단계적으로 설명하는 편이 좋다.

## Preferred Topics
- 자율주행 관련 주제
- 로봇 관련 주제
- 로봇의 동작 제어 주제

## Common AI Support Needs
- 제어 루프 구조 정리
- 회로/배선 연결 체크리스트 작성
- 전원 및 구동계 연결 검증 절차 정리
- 모터 명령과 측정 데이터 로깅 항목 설계
- 펌웨어 디버깅 체크리스트 작성
- 실기기 테스트 절차 정리
- PID 파라미터 조정 전략 정리

## Response Priorities
1. 제어 입력, 제어 출력, 측정값 흐름을 명확히 구분한다.
2. 회로 구성, 배선, 전원 연결 상태와 안전성을 먼저 고려한다.
3. 실제 하드웨어 적용 시 검증 절차와 파라미터 조정 절차를 실험 중심으로 설명한다.
4. 로그 수집 항목과 테스트 조건을 빠뜨리지 않는다.

## Related Documents
- `fulltext.md`
- `README.md`
- `AGENTS.md`
