lemon56789/delta_robot_proj/docs/daily_notes/2026-05-08.md

# Daily Note - 2026-05-08

## Entry 001
- 무엇을:
  - `docs/plans/2026-05-08_001_workspace_envelope_doc.md` 계획서를 작성했다.
  - `docs/workspace_envelope.md`를 추가해 설치 높이와 `XY` 작업공간 계산 결과를 정리했다.
  - `H=255/265/290 mm` 비교와 `H=290 mm` 바닥 기준 단면 표를 문서에 남겼다.
- 왜:
  - 대화 중 계산한 적정 설치 높이와 `XY` 면적 결과가 흩어지지 않고, 이후 기구 설계와 작업면 선정에서 재사용 가능해야 했기 때문이다.
  - 현재 SoT 문서의 좌표계/geometry 기준을 유지한 채 설치 높이 판단 근거를 별도 참고 문서로 남길 필요가 있었기 때문이다.
- 어떻게:
  - 현재 nominal geometry와 `base_frame` 좌표계를 기준으로 `theta = -45..90 deg` 탐색 조건에서 `z`별 `XY` reachable area를 스캔한 결과를 정리했다.
  - `z=-175 mm` 최대 단면, `z=-215..-235 mm` 접근층, `H=290 mm` 바닥 기준 단면을 표로 요약했다.
  - `-45..90 deg`는 현재 hardware-safe SoT가 아니라 설치 검토용 확장 탐색 범위라는 점을 문서에 명시했다.
- 결과:
  - 설치 높이와 실제 바닥 기준 작업공간을 빠르게 조회할 수 있는 문서가 추가되었다.
  - `H=255 mm`를 일반적인 pick-and-place 기준 추천 높이로, `H=290 mm`를 떠 있는 tray/jig 작업에 유리한 대안으로 정리할 수 있게 되었다.
- 변경 파일:
  - `docs/plans/2026-05-08_001_workspace_envelope_doc.md`
  - `docs/workspace_envelope.md`
  - `docs/daily_notes/2026-05-08.md`
- 다음:
  - 실제 gripper tip offset과 workpiece/tray height를 반영해 최종 설치 높이 범위를 다시 계산한다.
  - 필요하면 `experiments/kinematics/`에 본 문서 수치와 대응하는 저장용 CSV/JSON을 별도 생성한다.

## Entry 002
- 무엇을:
  - `docs/plans/2026-05-08_002_update_sot_angle_range_to_minus45.md` 계획서를 작성했다.
  - `docs/system_data_flow.md`, `docs/ik_structure_note.md`, `docs/roadmap.md`, `docs/workspace_envelope.md`, `fulltext.md`의 angle range 기준을 갱신했다.
- 왜:
  - 기존 `0..90 deg` provisional range는 정확한 하드웨어 범위를 몰라 보수적으로 둔 값이었고, 현재 팀 판단 기준에서는 `-45..90 deg`를 임시 운용 범위로 쓰는 편이 더 일관되기 때문이다.
  - 설치 높이와 workspace envelope 문서가 현재 SoT와 서로 다른 angle range를 쓰면 이후 해석과 설계 판단에 혼선이 생기기 때문이다.
- 어떻게:
  - `hardware-confirmed`는 여전히 미확정으로 두고, `hardware-safe provisional`과 `nominal-analysis`를 모두 `-45 deg <= theta_i <= 90 deg`로 맞췄다.
  - workspace envelope 문서의 주의 문구도 현재 SoT 기준에 맞게 갱신했다.
- 결과:
  - 현재 기준 문서들에서 angle range 표현이 `-45..90 deg`로 정렬되었다.
  - 이후 설치 높이, workspace, trajectory safe zone 검토가 같은 범위를 기준으로 이뤄질 수 있게 되었다.
- 변경 파일:
  - `docs/plans/2026-05-08_002_update_sot_angle_range_to_minus45.md`
  - `docs/system_data_flow.md`
  - `docs/ik_structure_note.md`
  - `docs/roadmap.md`
  - `docs/workspace_envelope.md`
  - `fulltext.md`
  - `docs/daily_notes/2026-05-08.md`
- 다음:
  - 실제 조립 및 반복 구동 기준에서 `hardware-confirmed angle range`를 별도 확정한다.
  - 필요하면 코드 기본값과 실험 스크립트 default도 현재 SoT 기준과 완전히 맞춘다.
