lemon56789/delta_robot_proj/docs/daily_notes/2026-05-11.md

# Daily Note - 2026-05-11

## Entry 001
- 무엇을:
  - `docs/plans/2026-05-11_001_update_fulltext_unreflected_items.md` 계획서를 작성했다.
  - `fulltext.md`의 갱신일, Stage 6 상태 표현, workspace envelope 참고 내용을 현재 SoT 기준으로 정리했다.
- 왜:
  - `fulltext.md`가 2026-05-08 반영 이후에도 갱신일이 2026-05-03으로 남아 있었고, `docs/workspace_envelope.md`와 Stage 6 상태 표현이 현재 SoT와 완전히 맞지 않았기 때문이다.
- 어떻게:
  - `docs/roadmap.md`, `docs/workspace_envelope.md`, `docs/daily_notes/2026-05-08.md`를 대조해 요약 문서에 필요한 최소 수정만 반영했다.
  - Stage 6은 `진행 중` 상태와 현재 확보된 산출물 범위가 함께 드러나도록 문구를 조정했다.
- 결과:
  - `fulltext.md`가 최신 SoT 문서 기준과 더 일관된 요약본이 되었다.
  - workspace envelope 참고 문서와 설치 높이 판단 맥락이 외부 AI용 요약에도 드러나게 되었다.
- 다음:
  - 이후 로드맵 상태나 설치 검토 기준이 바뀌면 `fulltext.md`도 같은 변경 턴에서 함께 갱신한다.
