lemon56789/delta_robot_proj/docs/plans/2026-05-11_001_update_fulltext_unreflected_items.md

# Plan

## Goal
`fulltext.md`를 현재 SoT 문서 상태에 맞게 갱신해 문서 메타데이터, Stage 6 상태 표현, workspace envelope 참고 문서를 일치시킨다.

## Files
- `docs/plans/2026-05-11_001_update_fulltext_unreflected_items.md`
- `fulltext.md`
- `docs/daily_notes/2026-05-11.md`

## Changes
- `fulltext.md`의 `갱신일`을 실제 최신 반영일 기준으로 수정한다.
- `docs/workspace_envelope.md`의 존재와 역할, 핵심 설치 높이/workspace 참고 성격을 `fulltext.md`에 추가한다.
- Stage 6 상태 표현을 SoT인 `docs/roadmap.md`와 맞춰 `진행 중` 의미로 조정한다.
- 참조 문서 목록에 `docs/workspace_envelope.md`를 추가한다.
- 변경 근거와 결과를 오늘 Daily Note에 기록한다.

## Impact
- 요약 문서와 SoT 문서 간 불일치를 줄인다.
- 데이터 계약, 인터페이스, 폴더 구조는 변경하지 않는다.

## Risk
- `fulltext.md`는 요약본이므로 새 문서 내용을 과도하게 상세화하면 SoT와 역할이 겹칠 수 있다.
- 날짜 표기는 문서 최신 수정일과 상태 기준일을 혼동하지 않게 유지해야 한다.

## Validation
- `fulltext.md`의 날짜, Stage 6 표현, workspace envelope 언급을 `docs/roadmap.md`, `docs/workspace_envelope.md`, `docs/daily_notes/2026-05-08.md`와 대조 확인한다.
