lemon56789/delta_robot_proj/docs/daily_notes/2026-04-20.md

# Daily Note - 2026-04-20

## Entry 001
- 무엇을:
  - `docs/plans/2026-04-20_001_update_fulltext_current_progress.md` 계획서를 작성했다.
  - `fulltext.md`를 현재 프로젝트 문서 상태에 맞게 갱신했다.
- 왜:
  - 기존 `fulltext.md`가 2026-03-22 기준 초기 요약에 머물러 있어, 이후 정리된 시스템 데이터 흐름, 비전 ground-truth, IK 수식, 로드맵 상태가 반영되어 있지 않았기 때문이다.
- 어떻게:
  - `docs/system_data_flow.md`, `docs/vision_tracking.md`, `docs/ik_structure_note.md`, `docs/roadmap.md`, 최근 Daily Note 내용을 기준으로 외부 AI용 통합 요약을 다시 구성했다.
  - CSV 계약은 현재 `theta*_cmd`, `theta*_meas`, `error_*` 명명 기준으로 반영했다.
  - 비전 시스템은 운영 센서가 아니라 학습/검증용 외부 `XY ground-truth` 측정계로 정리했다.
  - IK는 `theta_i` 정의, `B_i/P_i/J_i`, `E_i/F_i/G_i`, 반각 치환, root selection, 미정 항목을 요약했다.
- 결과:
  - `fulltext.md`가 2026-04-20 기준 프로젝트 상태를 반영하는 외부 AI용 요약본으로 갱신되었다.
  - 코드, 데이터 포맷, 공개 인터페이스, 폴더 구조 변경은 발생하지 않았다.
- 변경 파일:
  - `docs/plans/2026-04-20_001_update_fulltext_current_progress.md`
  - `fulltext.md`
  - `docs/daily_notes/2026-04-20.md`
- 다음:
  - `kinematics/`에 `delta_IK(x, y, z)` 함수 시그니처와 구현 계획을 만들고, 이후 sample point 테스트와 FK 검증 구조로 이어간다.
