lemon56789/delta_robot_proj/docs/plans/2026-04-20_001_update_fulltext_current_progress.md

# Plan

## Goal
Update `fulltext.md` so an external AI model can understand the current project state after the documentation work completed through 2026-04-09.

## Files
- `fulltext.md`
- `docs/plans/2026-04-20_001_update_fulltext_current_progress.md`
- `docs/daily_notes/2026-04-20.md`

## Changes
- Update the `fulltext.md` date to 2026-04-20.
- Add current system data flow, coordinate frame, timestamp, CSV, correction, and validation summaries.
- Add vision-based `XY ground-truth` measurement summary.
- Add current IK documentation status, including theta definition, geometry mapping, E/F/G form, half-angle solution, and root selection rules.
- Add roadmap status and next actions.
- Record the document update in today's Daily Note.

## Impact
Documentation only. No code, data format, public interface, or folder contract changes are made.

## Risk
- `fulltext.md` is a summary file, so it may become inconsistent with detailed source documents if future changes are not synchronized.
- Some implementation details remain open because they are not yet decided in the source documents.

## Validation
- Check that `fulltext.md` remains a summary and points to `docs/*` as the source of truth.
- Check that current CSV and IK terms match `docs/system_data_flow.md` and `docs/ik_structure_note.md`.
- Check that today's Daily Note lists all changed files.
