lemon56789/delta_robot_proj/docs/daily_notes/2026-04-09.md

# Daily Note - 2026-04-09

## Entry 001
- 무엇을:
  - `docs/plans/2026-04-09_001_refine_ik_structure_note_and_add_impl_flow.md` 계획서를 작성했다.
  - `docs/ik_structure_note.md`에 `IK Implementation Flow` 섹션을 추가하고, 오래된 진행형 서술을 정리했다.
- 왜:
  - 현재 문서는 수식은 많이 정리되어 있었지만, 실제 구현 관점에서 한 번에 읽히는 요약 흐름이 부족했고, 이미 끝난 단계를 미래 작업처럼 적은 부분이 남아 있었기 때문이다.
- 어떻게:
  - 입력, `E/F/G` 계산, 판별식, 반각 치환, 해 선택, 반환 순서를 구현 관점으로 다시 묶었다.
  - 이미 반영된 항목은 `Remaining Open Items`만 남기도록 정리하고, 중복된 진행형 문구를 제거했다.
- 결과:
  - `docs/ik_structure_note.md`가 단순 메모보다 구현 준비 문서에 가까운 형태로 읽히게 되었다.
- 변경 파일:
  - `docs/plans/2026-04-09_001_refine_ik_structure_note_and_add_impl_flow.md`
  - `docs/ik_structure_note.md`
  - `docs/daily_notes/2026-04-09.md`
- 다음:
  - 필요하면 `kinematics/`에 실제 IK 함수 시그니처와 테스트 포인트를 구현 계획으로 분리한다.

## Entry 002
- 무엇을:
  - `docs/plans/2026-04-09_002_add_project_roadmap.md` 계획서를 작성했다.
  - `docs/roadmap.md`를 신규 작성해 프로젝트 전체 로드맵을 통합 정리했다.
- 왜:
  - 현재 리포에는 README 수준의 큰 단계와 기술별 세부 문서는 있었지만, 프로젝트 전체 실행 단계를 한 문서에서 자세히 따라갈 수 있는 로드맵이 없었기 때문이다.
- 어떻게:
  - 기존 운동학 체크리스트의 강점을 유지하면서, 설계 기준, FK 검증, 시뮬레이션/데이터, 비전 ground-truth, fake pipeline, 실제 데이터 수집, 가상센싱, 운영 검증까지 포함한 단계형 문서로 재구성했다.
- 결과:
  - 프로젝트 전체 진행 순서를 한 문서에서 확인할 수 있는 실행 로드맵이 생겼다.
- 변경 파일:
  - `docs/plans/2026-04-09_002_add_project_roadmap.md`
  - `docs/roadmap.md`
  - `docs/daily_notes/2026-04-09.md`
- 다음:
  - 필요하면 `README.md`에서 `docs/roadmap.md`로 연결되는 짧은 참조를 추가한다.

## Entry 003
- 무엇을:
  - `docs/plans/2026-04-09_003_link_readme_to_roadmap_and_add_status_note.md` 계획서를 작성했다.
  - `README.md`에 `docs/roadmap.md` 참조를 추가하고, roadmap 기준 현재 진행 상태를 정리했다.
- 왜:
  - README에서 상세 실행 계획 문서로 바로 이동할 수 있어야 하고, 다음에 문서를 다시 열었을 때 현재 어디까지 왔는지와 바로 다음 작업이 한눈에 보여야 하기 때문이다.
- 어떻게:
  - `README.md`의 진행 단계 섹션 상단에 roadmap 참조 문구를 추가했다.
  - roadmap 단계별로 완료/부분 완료/미착수 상태를 정리하고, 바로 다음 작업 우선순위를 함께 적었다.
- 결과:
  - README와 roadmap이 연결되었고, 오늘 기준 프로젝트 상태와 다음 액션이 Daily Note에 남았다.
- 변경 파일:
  - `docs/plans/2026-04-09_003_link_readme_to_roadmap_and_add_status_note.md`
  - `README.md`
  - `docs/daily_notes/2026-04-09.md`
- 다음:
  - `kinematics/`에 실제 IK 함수 시그니처와 테스트 계획을 추가하고 구현 착수 계획서를 작성한다.

## Roadmap Status - 2026-04-09
- Stage 1. 설계 기준 확정: 대부분 완료
  - 좌표계, `theta_i` 정의, CSV 기본 구조, 시스템 데이터 흐름, IK 문서 구조가 정리됨
  - 남은 항목: 최종 기구 파라미터 수치, 최종 하드웨어 각도 범위
- Stage 2. 운동학 정의 및 구현: 문서 정리 완료, 코드 미구현
  - `docs/ik_structure_note.md`에 `B_i`, `P_i`, `J_i`, `E_i`, `F_i`, `G_i`, 반각 치환, 해 선택 규칙, 대칭 확장까지 정리됨
  - 아직 `kinematics/`에 실제 IK 함수가 없음
- Stage 3. FK 검증 및 기본 해석: 미착수
  - FK 수식/코드/왕복 검증 스크립트 없음
- Stage 4. 시뮬레이션 및 데이터 경로 정리: 부분 완료
  - `docs/system_data_flow.md`에 simulation path, alignment policy, CSV contract 초안이 있음
  - 실제 simulation 자산 연결과 merged dataset 규칙은 미완성
- Stage 5. 외부 Ground-Truth 측정계 구축: 문서화 완료, 구현 미착수
  - `docs/vision_tracking.md`와 `data/vision/raw/` 경로가 준비됨
  - 카메라 설치, calibration, 실제 수집은 아직 안 함
- Stage 6. Fake Pipeline 구성: 미착수
  - 현재 가장 시급한 구현 작업 중 하나
- Stage 7. 실제 데이터 수집: 미착수
- Stage 8. 가상센서 학습 및 보정: 미착수
- Stage 9. 폐루프 적용 및 성능 검증: 미착수
- Stage 10. 외부 측정계 제거 후 운영 검증: 미착수

## Next Actions
1. `kinematics/`에 `delta_IK(x, y, z)` 함수 시그니처와 구현 계획을 만든다.
2. IK 코드 구현 후 sample point 테스트를 붙인다.
3. FK 최소 검증 구조를 정한다.
4. fake pipeline 범위와 출력 형식을 계획서로 고정한다.
5. fake pipeline에서 사용할 CSV 생성 스크립트 구현으로 이어간다.
