lemon56789/delta_robot_proj/docs/plans/2026-04-06_012_expand_arm1_efg.md

# Plan

## Goal
arm 1의 길이 제약식 `|P_1 - J_1|^2 = l^2`를 전개해 `E_1 cos(theta_1) + F_1 sin(theta_1) + G_1 = 0` 형태를 도출한다.
현재 단계에서는 arm 1만 정리하고, arm 2와 arm 3 대칭 확장은 다음 단계로 둔다.

## Files
- `docs/plans/2026-04-06_012_expand_arm1_efg.md`
- `docs/ik_structure_note.md`
- `docs/daily_notes/2026-04-06.md`

## Changes
- `docs/ik_structure_note.md`에 arm 1 길이 제약식 전개 과정을 추가한다.
- 중간 변수 정리와 함께 `E_1`, `F_1`, `G_1`를 명시한다.
- 변경 기록을 `docs/daily_notes/2026-04-06.md`에 추가한다.

## Impact
- `2atan(t)` 기반 IK의 arm 1 대수식이 프로젝트 변수 기준으로 처음 닫힌다.
- 후속 arm 2, arm 3 확장과 해 선택 규칙 정리의 기반이 된다.

## Risk
- 부호가 틀리면 이후 전체 IK가 흔들리므로 전개 과정을 명시적으로 남겨야 한다.
- arm 1 기준이므로 일반식처럼 읽히지 않게 범위를 분명히 해야 한다.

## Validation
- 전개된 식이 현재 `P_1`, `J_1` 정의와 일치하는지 확인한다.
- `E_1`, `F_1`, `G_1`가 `cos(theta_1)`, `sin(theta_1)`, 상수항으로 분리되는지 검토한다.
- `theta_1 = 0 deg`, `90 deg` 해석과 부호가 충돌하지 않는지 확인한다.
