lemon56789/delta_robot_proj/docs/plans/2026-04-09_001_refine_ik_structure_note_and_add_impl_flow.md

# Plan

## Goal
`docs/ik_structure_note.md`에 IK 구현 흐름 요약 섹션을 추가하고, 이미 완료된 유도 단계를 미래형으로 남겨둔 중복 서술을 정리한다.
문서는 유지하되, 현재 상태 기준으로 바로 구현에 옮기기 쉬운 구조로 다듬는다.

## Files
- `docs/plans/2026-04-09_001_refine_ik_structure_note_and_add_impl_flow.md`
- `docs/ik_structure_note.md`
- `docs/daily_notes/2026-04-09.md`

## Changes
- `docs/ik_structure_note.md`에 `IK Implementation Flow` 섹션을 추가한다.
- 이미 정리된 내용을 다시 미래 작업처럼 적은 문구를 현재 상태에 맞게 수정한다.
- 현재 남은 미확정 항목만 간결하게 남긴다.
- 변경 기록을 `docs/daily_notes/2026-04-09.md`에 추가한다.

## Impact
- 문서가 구현 준비 문서로 더 직접적으로 읽힌다.
- 중복과 오래된 진행 메모가 줄어든다.

## Risk
- 너무 많이 줄이면 유도 맥락이 약해질 수 있으므로 핵심 유도식은 유지한다.

## Validation
- `IK Implementation Flow`가 입력부터 해 선택까지 순서대로 읽히는지 확인한다.
- 삭제/수정 후에도 기존 좌표계, EFG, 반각 치환, 해 선택 규칙이 모두 남아 있는지 검토한다.
