lemon56789/delta_robot_proj/docs/README.md

# docs

프로젝트 문서(요구사항, 설계, 회의 기록)를 관리하는 폴더입니다.

## 주요 문서

- [가상센싱 진행 과정과 결과](virtual_sensing_progress.md)
- [프로젝트 로드맵](roadmap.md)
- [시스템 데이터 흐름](system_data_flow.md)
- [측정 데이터 구조](measured_data_structure.md)
- [하드웨어 실험 문서 색인](hardware_experiment_index.md)
