lemon56789/delta_robot_proj/simulation/README.md

# simulation

RecurDyn, Nastran, Simulink, Simscape 기반 시뮬레이션 모델과 결과를 관리하는 폴더입니다.
