lemon56789/delta_robot_proj/docs/member_profiles/N.md

# N Profile

## Role
하드웨어 제작/조립, 프로파일 주문제작 요청 담당. 구조 및 응력 해석은 기획 단계 담당 범위로 유지한다.

## AI Prompt Seed
N은 하드웨어 제작과 구조 검토 관점에서 답변을 원한다. 실제 제작/주문제작 이슈를 먼저 정리하고, 필요 시 하중, 경계조건, 재료 가정 같은 기획 단계 구조/응력 해석 관점과 연결하라.

## Background
- 고체역학실습과 응용고체역학에서 Inventor, Nastran을 이용해 각각 포신과 광고판의 응력 해석을 진행한 경험이 있다.
- 열전달 및 열유체실습에서는 Fluent를 이용한 비행기 전기실의 열 방출 해석에 참여했다.
- 진동동역학실습에서는 레고 차량의 조종을 맡았다.
- 현재 기계요소설계 과목을 수강 중이다.
- 고체역학, 기계재료, 자동차공학 관련 주제를 선호한다.
- 유체역학, 기구학 관련 분야와 프로그래밍에는 약할 수 있다.

## Scope
- 델타 로봇 하드웨어 제작 및 조립 참여
- 프로파일 주문제작 요청과 제작 사양 확인
- 프레임 및 부품의 구조 강성 검토
- 기획 단계에서 응력 분포, 취약 지점, 재료 관점의 설계 리스크 검토
- 시간 제약상 심화 구조/응력 해석은 실제 주 산출물보다 기획 및 해석 후보 범위로 둔다.

## Primary Directories
- `simulation/`
- `cad/`
- `hardware/`
- `docs/`

## Tools
- Inventor
- Nastran
- Fluent

## Strengths
- 하드웨어 제작/조립 및 프로파일 주문제작 요청 과정의 실제 참여
- 응력 해석과 구조 강성 검토 경험
- 재료와 구조 관점에서 설계 리스크를 찾는 데 적합함
- 열 방출 해석 경험이 있어 구조와 열 해석을 함께 고려할 수 있음

## Weaknesses Or Cautions
- 유체역학, 기구학 관련 분야는 상대적으로 약할 수 있다.
- 프로그래밍이 핵심인 질문은 구현보다는 해석 요구 정리 중심으로 지원하는 편이 좋다.

## Preferred Topics
- 고체역학 관련 주제
- 기계재료 관련 주제
- 자동차공학 관련 주제
- 구조 및 응력 해석 주제

## Common AI Support Needs
- 프로파일 주문제작 사양과 제작 체크리스트 정리
- 실제 제작 상태와 구조 요구사항 비교
- 구조 해석 조건 정리
- 경계조건과 하중조건 검토
- 응력 결과 해석 기준 정리
- 설계 보강안 비교
- 재료 선택과 구조 리스크 연결 정리

## Response Priorities
1. 실제 제작/조립 상태와 프로파일 주문제작 관련 이슈를 먼저 정리한다.
2. 필요한 경우 하중, 경계조건, 재료 가정을 구조 검토 관점에서 명확히 한다.
3. 구조 해석 관점은 설계 의사결정과 연결하되, 시간 제약상 기획 단계 범위임을 구분한다.
4. 프로그래밍보다는 제작 조건, 구조 요구사항, 결과 비교 기준을 중심으로 설명한다.

## Related Documents
- `fulltext.md`
- `README.md`
- `AGENTS.md`
