lemon56789/delta_robot_proj/docs/plans/2026-06-05_001_record_run_00_ab_pass.md

# Plan

## Goal
Run 00의 A/B gate 통과 상태를 문서에 기록한다.

## Files
- `docs/plans/2026-06-05_001_record_run_00_ab_pass.md`
- `docs/hardware_experiment_run_00_commissioning.md`
- `docs/daily_notes/2026-06-05.md`

## Changes
- Run 00 post-run validation에서 A result를 pass로 기록한다.
- Run 00 post-run validation에서 B result를 pass로 기록한다.
- C result와 Run 01 readiness는 vision readiness check 전이므로 pending으로 둔다.
- 기록 근거는 사용자 보고 기준임을 notes에 남긴다.

## Impact
- 하드웨어 실험 상태 문서만 갱신한다.
- 코드, CSV 포맷, 제어 인터페이스는 변경하지 않는다.

## Risk
- A/B 세부 로그 파일이나 수치 확인이 아직 문서에 연결되지 않았으므로, pass 기록은 사용자 보고 기준이다.
- C가 아직 남아 있으므로 Run 01 baseline 준비 완료로 해석하면 안 된다.

## Validation
- A/B pass와 C pending 상태가 명확히 구분되는지 확인한다.
- `git diff --check`로 Markdown 공백 오류를 확인한다.
