lemon56789/delta_robot_proj/docs/plans/2026-06-05_002_record_virtual_sensing_prerequisites.md

# Plan

## Goal
가상센싱 진행 전 남은 gate와 다음 작업 흐름을 daily note에 보고용으로 기록한다.

## Files
- `docs/plans/2026-06-05_002_record_virtual_sensing_prerequisites.md`
- `docs/daily_notes/2026-06-05.md`

## Changes
- 현재 Run 00 A/B/C와 Run 01 상태를 요약한다.
- 가상센싱 전 최소 gate를 Run 00-C, Run 01 baseline 수집, alignment/merge, processed dataset validation 순서로 기록한다.
- Run 00-C와 Run 01에서 해야 할 핵심 항목을 보고용으로 정리한다.

## Impact
- 문서 기록만 추가한다.
- 코드, CSV 포맷, 실험 프로토콜 본문은 변경하지 않는다.

## Risk
- 실제 Run 01 trajectory와 processing command는 아직 확정 전이므로 별도 후속 문서화가 필요하다.

## Validation
- daily note에 보고 가능한 형태로 현재 gate와 다음 작업이 남았는지 확인한다.
