lemon56789/delta_robot_proj/docs/plans/2026-05-28_001_record_next_priority_tasks_in_daily_note.md

# Plan

## Goal
`docs/daily_notes/2026-05-28.md`를 생성하고, 현재 roadmap 기준 다음 우선작업 3개를 오늘 작업 메모로 기록한다.

## Files
- `docs/plans/2026-05-28_001_record_next_priority_tasks_in_daily_note.md`
- `docs/daily_notes/2026-05-28.md`

## Changes
- 오늘 작업용 계획서를 추가한다.
- `docs/daily_notes/2026-05-28.md`를 생성한다.
- 현재 `docs/roadmap.md` 기준 다음 우선작업 3개를 Daily Note에 기록한다.
  - Stage 4에서 `error_*` 의미와 Simulink/Simscape export를 SoT에 맞추는 작업
  - Simulink/Simscape 기준 모델과 실행 절차를 더 명확히 문서화하는 작업
  - Stage 5~7 연결 준비를 위해 real/vision/alignment 규칙을 구체화하는 작업

## Impact
- 오늘 시점의 다음 우선순위가 Daily Note에 고정된다.
- 이후 구현 또는 문서 작업을 어떤 순서로 이어갈지 팀 내 기준점이 생긴다.
- 코드, 데이터 계약, 폴더 구조는 변경하지 않는다.

## Risk
- 우선순위 메모 성격이므로 기능적 리스크는 낮다.
- 이후 실제 하드웨어 준비 상황이나 실험 여건이 바뀌면 후속 Daily Note에서 우선순위 조정이 필요할 수 있다.

## Validation
- `docs/daily_notes/2026-05-28.md`가 생성되었는지 확인한다.
- Daily Note에 우선작업 3개와 그 이유가 기록되었는지 확인한다.
- 내용이 현재 `docs/roadmap.md`와 충돌하지 않는지 확인한다.
