lemon56789/delta_robot_proj/docs/plans/2026-04-09_002_add_project_roadmap.md

# Plan

## Goal
프로젝트 전체 진행 단계를 한 문서에서 볼 수 있도록 `docs/roadmap.md`를 추가한다.
기존 운동학 체크리스트의 강점은 유지하고, 현재 프로젝트의 데이터, 비전, fake pipeline, 가상센싱, 운영 검증 흐름까지 통합한다.

## Files
- `docs/plans/2026-04-09_002_add_project_roadmap.md`
- `docs/roadmap.md`
- `docs/daily_notes/2026-04-09.md`

## Changes
- `docs/roadmap.md`를 신규 작성한다.
- 프로젝트 전체 단계를 설계 기준, 운동학 구현, FK 검증, 시뮬레이션/데이터 경로, 비전 ground-truth, fake pipeline, 실제 데이터 수집, 가상센싱, 폐루프 검증, 운영 전환까지 통합해 정리한다.
- Immediate priorities, open items, 관련 문서 관계를 함께 정리한다.
- 변경 기록을 `docs/daily_notes/2026-04-09.md`에 추가한다.

## Impact
- 프로젝트 전체 진행 순서를 한 문서에서 확인할 수 있다.
- README의 요약 단계와 세부 기술 문서 사이를 연결하는 실행 로드맵이 생긴다.

## Risk
- 단계가 너무 많아 보이면 실행보다 문서가 과해 보일 수 있다.
- 실제 진행과 문서가 어긋나면 유지보수 부담이 생길 수 있다.

## Validation
- 로드맵이 현재 SoT 및 하위 문서와 충돌 없이 읽히는지 확인한다.
- 운동학, 데이터, 비전, 가상센싱, 운영 검증이 모두 포함되는지 검토한다.
- immediate priorities와 open items가 현재 상태와 맞는지 확인한다.
