lemon56789/delta_robot_proj/docs/plans/2026-04-09_003_link_readme_to_roadmap_and_add_status_note.md

# Plan

## Goal
`README.md`에서 `docs/roadmap.md`로 연결되는 최소 참조를 추가하고, `docs/daily_notes/2026-04-09.md`에 roadmap 기준 현재 완료 상태와 다음 작업을 정리한다.
다음에 문서를 다시 볼 때 현재 위치와 바로 이어서 할 작업을 빠르게 파악할 수 있게 한다.

## Files
- `docs/plans/2026-04-09_003_link_readme_to_roadmap_and_add_status_note.md`
- `README.md`
- `docs/daily_notes/2026-04-09.md`

## Changes
- `README.md`에 상세 실행 계획이 `docs/roadmap.md`에 있다는 최소 문구를 추가한다.
- `docs/daily_notes/2026-04-09.md`에 roadmap 기준 현재 완료/부분 완료/미착수 상태를 요약한다.
- 같은 Daily Note에 바로 다음 작업 우선순위를 적는다.

## Impact
- README에서 프로젝트 세부 실행 계획 문서로 바로 이동할 수 있다.
- 현재 프로젝트 위치와 다음 작업이 Daily Note에 남아 이어보기 쉬워진다.

## Risk
- 상태 요약이 실제 진행과 어긋나면 다음 작업 판단이 흔들릴 수 있다.
- README 문구가 길어지면 요약 문서의 역할을 해칠 수 있으므로 최소 수준으로 유지해야 한다.

## Validation
- README에서 roadmap 경로를 자연스럽게 찾을 수 있는지 확인한다.
- Daily Note 상태 요약이 현재 리포 상태와 맞는지 검토한다.
- 다음 작업 우선순위가 roadmap과 현재 구현 수준에 맞는지 확인한다.
