lemon56789/delta_robot_proj/docs/plans/2026-03-26_014_readme_process_diagram.md

# Plan

## Goal
- `README.md`에 프로젝트 과정을 한눈에 볼 수 있는 다이어그램을 추가해 문서 가독성을 높인다.

## Files
- `docs/plans/2026-03-26_014_readme_process_diagram.md`
- `README.md`
- `docs/daily_notes/2026-03-26.md`

## Changes
- `README.md`에 프로젝트 진행 단계용 Mermaid 다이어그램을 추가한다.
- 기존 시스템 구조 설명도 Mermaid 다이어그램으로 시각화해 텍스트 흐름보다 빠르게 이해할 수 있게 정리한다.
- 오늘자 Daily Note에 변경 목적, 방법, 결과, 변경 파일, 다음 작업을 기록한다.

## Impact
- README 첫인상과 구조 이해 속도가 개선된다.
- 코드, 데이터 포맷, 공개 인터페이스에는 영향이 없다.

## Risk
- Markdown 렌더러에 따라 Mermaid 지원 여부 차이가 있을 수 있다.

## Validation
- `README.md`에서 Mermaid 블록 문법이 정상적으로 보이는지 확인
- 다이어그램 내용이 현재 시스템 구조 및 진행 단계 설명과 충돌하지 않는지 확인
- `docs/daily_notes/2026-03-26.md`에 변경 기록이 남았는지 확인
