lemon56789/delta_robot_proj/docs/plans/2026-03-26_015_readme_stage_diagram_refine.md

# Plan

## Goal
- `README.md`의 진행 단계 표현을 PowerPoint 스타일에 가까운 박스형 다이어그램과 체크박스 기반 진행 현황으로 개선한다.

## Files
- `docs/plans/2026-03-26_015_readme_stage_diagram_refine.md`
- `README.md`
- `docs/daily_notes/2026-03-26.md`

## Changes
- `README.md`의 진행 단계 Mermaid 다이어그램을 단계별 박스 묶음 구조로 재작성한다.
- 각 단계에 세부 작업 체크박스를 추가해 진행 현황을 바로 표시할 수 있게 한다.
- 오늘자 Daily Note에 변경 이유와 결과를 기록한다.

## Impact
- README에서 프로젝트의 전체 단계와 현재 진행 체크 포인트를 더 직관적으로 확인할 수 있다.
- 코드, 데이터 포맷, 인터페이스에는 영향이 없다.

## Risk
- Mermaid 렌더러에 따라 박스 내부 줄바꿈 표현이 다르게 보일 수 있다.
- 실제 완료 상태는 별도 업데이트가 필요하다.

## Validation
- `README.md`의 Mermaid 다이어그램이 문법 오류 없이 표시되는지 확인
- 체크박스와 단계 설명이 기존 진행 단계 설명과 일치하는지 확인
- `docs/daily_notes/2026-03-26.md`에 변경 기록이 반영되었는지 확인
