lemon56789/delta_robot_proj/docs/plans/2026-03-26_011_system_data_flow_owner_mapping.md

# Plan

## Goal
- `docs/system_data_flow.md`의 `Owner Mapping` 섹션에 기존 역할 기준을 반영한다.

## Files
- `docs/system_data_flow.md`
- `docs/daily_notes/2026-03-26.md`

## Changes
- `S`, `L`, `Y`, `T`, `Team`의 owner mapping 기본값을 문서에 채운다.
- block별 owner를 앞서 사용한 역할 분담 기준에 맞춰 반영한다.

## Impact
- 데이터 흐름 문서가 인터페이스 정의뿐 아니라 작업 책임 분담 기준으로도 바로 사용 가능해진다.

## Risk
- 실제 운영 중 owner가 바뀌면 후속 업데이트가 필요하다.

## Validation
- `docs/system_data_flow.md`에 owner mapping이 반영되었는지 확인
- Daily Note에 변경 이유와 결과가 기록되었는지 확인
