lemon56789/delta_robot_proj/docs/plans/2026-03-26_012_system_data_flow_finalize_v0_1.md

# Plan

## Goal
- `docs/system_data_flow.md`의 남은 `Validation Criteria`와 `Open Questions`를 채워 문서를 1차 완성 상태로 마무리한다.

## Files
- `docs/system_data_flow.md`
- `docs/daily_notes/2026-03-26.md`

## Changes
- `Validation Criteria`에 최소 검증 지표와 재현성 기록 규칙을 반영한다.
- `Open Questions`에 현재 미정 항목을 명시한다.

## Impact
- 문서가 데이터 흐름, 책임, 검증, 미정 항목까지 포함한 1차 기준 문서가 된다.

## Risk
- 일부 항목이 아직 정성적 수준이라 후속 실험 설계 단계에서 수치 기준 추가가 필요하다.

## Validation
- `docs/system_data_flow.md`의 11개 섹션이 모두 채워졌는지 확인
- Daily Note에 변경 이유와 결과가 기록되었는지 확인
