lemon56789/delta_robot_proj/docs/plans/2026-03-26_013_system_data_flow_title_cleanup.md

# Plan

## Goal
- `docs/system_data_flow.md`를 템플릿 문서가 아니라 실제 기준 문서로 보이도록 제목과 상단 문구를 정리한다.

## Files
- `docs/system_data_flow.md`
- `docs/daily_notes/2026-03-26.md`

## Changes
- 문서 제목에서 `Input Template` 표현을 제거한다.
- 상단에 문서 목적 설명을 추가해 실제 운영 문서 형식으로 정리한다.

## Impact
- 문서가 템플릿이 아니라 현재 프로젝트의 기준 데이터 흐름 문서로 바로 읽힌다.

## Risk
- 없음

## Validation
- `docs/system_data_flow.md` 제목과 상단 문구가 실제 문서 형식으로 반영되었는지 확인
- Daily Note에 변경 이유와 결과가 기록되었는지 확인
