lemon56789/delta_robot_proj/docs/daily_notes/2026-03-22.md

# Daily Note - 2026-03-22

## Entry 001
- 무엇을:
  - `AGENTS.md` 정합성 점검 결과를 반영해 정책/경로/버전/용어를 정리했다.
  - `docs/plans/`, `docs/daily_notes/`, `docs/templates/` 디렉터리를 생성했다.
  - 외부 AI 분석용 통합 문서 `fulltext.md`를 신규 작성했다.
  - 템플릿 파일(`plan_template.md`, `daily_note_template.md`)을 추가했다.
  - 복사 과정에서 생성된 `Zone.Identifier` 파일 2개를 삭제했다.
- 왜:
  - 문서 규칙과 실제 리포 상태의 불일치를 해소하고, 이후 작업 흐름(계획-승인-구현-기록)을 바로 적용 가능한 상태로 맞추기 위해.
  - 외부 AI 지원 시 프로젝트 컨텍스트를 빠르게 전달할 단일 문서가 필요해서.
- 어떻게:
  - 리포 구조와 `AGENTS.md`를 비교 검토한 뒤 사용자 확인 사항(5개)을 기준으로 패치 적용.
  - 문서/폴더/템플릿/요약 문서를 직접 생성하고 최종 경로 및 내용 검증 수행.
- 결과:
  - 경로 표기(`docs/...`)와 정책(모든 수정 전 계획+승인)이 일관되게 정리됨.
  - Python 버전 표기가 현재 환경(3.12.3)과 일치함.
  - `fulltext.md` 기반의 외부 AI 컨텍스트 제공 체계 확보.
  - 문서 운영용 디렉터리/템플릿이 준비됨.
  - 불필요한 `Zone.Identifier` 파일 제거 완료.
- 변경 파일:
  - `AGENTS.md`
  - `fulltext.md`
  - `docs/templates/plan_template.md`
  - `docs/templates/daily_note_template.md`
  - `docs/plans/.gitkeep`
  - `docs/daily_notes/.gitkeep`
  - `docs/daily_notes/2026-03-22.md`
  - (삭제) `AGENTS.md:Zone.Identifier`
  - (삭제) `AGENTS (1).md:Zone.Identifier`
- 다음:
  - 다음 코드/문서 변경 전 `docs/plans/`에 작업 계획서부터 작성.
  - `fulltext.md`는 주요 구현/실험 진척 시 주기적으로 업데이트.

## Entry 002
- 무엇을:
  - 외부 AI 입력용 팀원별 프로필 문서 체계를 `docs/member_profiles/` 아래에 추가했다.
  - 팀원별 프로필 5종(`S`, `L`, `Y`, `T`, `N`)과 사용법 문서를 작성했다.
  - 해당 작업에 대한 계획서를 `docs/plans/2026-03-22_001_member_profiles.md`로 기록했다.
- 왜:
  - `fulltext.md`는 공통 프로젝트 컨텍스트로 유지하고, 팀원별 최적화 정보는 별도 문서로 분리해 관리하기 위해.
  - 외부 AI에 공통 문서와 개인화 문서를 조합해 넣는 운영 방식을 명확히 하기 위해.
- 어떻게:
  - `README.md`의 팀원 역할 표를 기준으로 각 팀원의 담당 범위와 우선 지원 유형을 역할 중심으로 정리했다.
  - `docs/member_profiles/README.md`에 문서 목적, 사용법, 작성 원칙을 명시했다.
  - 오늘자 계획서와 변경 내역을 문서 규칙에 맞춰 함께 기록했다.
- 결과:
  - `fulltext.md`와 팀원 프로필 문서를 조합해 외부 AI에 입력할 수 있는 구조가 마련됐다.
  - 공통 정보와 팀원별 정보를 분리해 유지보수 범위가 명확해졌다.
  - 초기 프로필 문서는 현재 공개된 역할 정보를 기준으로 정리된 1차 버전으로 확보됐다.
- 변경 파일:
  - `docs/plans/2026-03-22_001_member_profiles.md`
  - `docs/member_profiles/README.md`
  - `docs/member_profiles/S.md`
  - `docs/member_profiles/L.md`
  - `docs/member_profiles/Y.md`
  - `docs/member_profiles/T.md`
  - `docs/member_profiles/N.md`
  - `docs/daily_notes/2026-03-22.md`
- 다음:
  - 팀원별 실제 작업 방식과 선호 도구가 구체화되면 각 프로필 문서를 역할 중심 1차본에서 운영 중심 문서로 확장한다.
  - 필요 시 외부 AI 입력 예시를 추가해 팀 내 사용 방식을 표준화한다.

## Entry 003
- 무엇을:
  - 팀원들이 제공한 원본 이력과 선호 주제를 반영해 `docs/member_profiles/`의 프로필 문서 5개를 보강했다.
  - 약어를 풀어서 학부생 연구 프로그램, 진동동역학실습, 열전달 및 열유체실습 등으로 명시했다.
  - 강점, 주의점, 선호 주제 항목을 추가해 외부 AI 입력용 문서 활용도를 높였다.
  - 해당 작업 계획서를 `docs/plans/2026-03-22_002_member_profiles_enrichment.md`로 기록했다.
- 왜:
  - 기존 프로필이 역할 중심 1차 요약이라 팀원별 실제 경험과 선호를 충분히 반영하지 못했기 때문이다.
  - 외부 AI가 팀원별 배경지식과 약한 분야까지 반영해 더 맞춤형 답변을 하게 만들기 위해.
- 어떻게:
  - 사용자가 제공한 원본 기록을 각 팀원별로 구조화해 `Background`, `Strengths`, `Weaknesses Or Cautions`, `Preferred Topics` 항목에 반영했다.
  - 약어는 모두 풀어서 서술하고, 사용 툴은 실제 경험 기반으로 정리했다.
  - 기존 역할, 주요 디렉터리, AI 지원 우선순위는 유지하면서 경험 정보를 덧붙였다.
- 결과:
  - 팀원 프로필 문서가 역할 중심 요약에서 경험 기반 운영 문서로 확장됐다.
  - 외부 AI가 팀원별 강점, 관심 분야, 주의해야 할 주제를 구분해 답변할 수 있는 기반이 마련됐다.
  - 사용 툴과 선호 분야가 구체화되어 개인화 문서의 활용성이 높아졌다.
- 변경 파일:
  - `docs/plans/2026-03-22_002_member_profiles_enrichment.md`
  - `docs/member_profiles/S.md`
  - `docs/member_profiles/L.md`
  - `docs/member_profiles/Y.md`
  - `docs/member_profiles/T.md`
  - `docs/member_profiles/N.md`
  - `docs/daily_notes/2026-03-22.md`
- 다음:
  - 필요 시 각 팀원 문서에 외부 AI 입력 예시 프롬프트를 추가한다.
  - 실제 프로젝트 진행 중 드러나는 작업 패턴과 선호도를 반영해 프로필을 주기적으로 갱신한다.

## Entry 004
- 무엇을:
  - 팀원별 프로필 문서에 외부 AI 입력용 `AI Prompt Seed` 한 줄 지시문을 추가했다.
  - `docs/member_profiles/README.md`에 문서 조합 순서와 입력 예시를 추가했다.
  - 해당 작업 계획서를 `docs/plans/2026-03-22_003_member_profile_prompt_seed.md`로 기록했다.
- 왜:
  - `fulltext.md`와 팀원 프로필 문서를 외부 AI에 넣을 때 바로 사용할 수 있는 운영 문구가 필요했기 때문이다.
  - 같은 팀원 정보를 반복 설명하지 않고도 개인화된 응답을 유도하기 위해.
- 어떻게:
  - 각 팀원의 강점과 응답 우선순위를 바탕으로 한 줄 지시문을 작성했다.
  - `docs/member_profiles/README.md`에 `fulltext.md`, 팀원 프로필, `AI Prompt Seed`, 현재 작업 요청 순서의 입력 패턴을 명시했다.
  - 오늘자 작업 기록에 변경 파일과 목적을 추가했다.
- 결과:
  - 팀원별 문서를 외부 AI에 바로 붙여 넣을 수 있는 형태로 정리했다.
  - 팀원별 개인화 문서의 실사용성이 높아졌다.
  - 문서 조합 방식이 표준화되어 팀 내 공유가 쉬워졌다.
- 변경 파일:
  - `docs/plans/2026-03-22_003_member_profile_prompt_seed.md`
  - `docs/member_profiles/README.md`
  - `docs/member_profiles/S.md`
  - `docs/member_profiles/L.md`
  - `docs/member_profiles/Y.md`
  - `docs/member_profiles/T.md`
  - `docs/member_profiles/N.md`
  - `docs/daily_notes/2026-03-22.md`
- 다음:
  - 실제 외부 AI 사용 사례를 바탕으로 `AI Prompt Seed` 문구를 미세 조정한다.
  - 필요 시 팀원별 자주 묻는 작업 유형에 대한 예시 프롬프트 세트를 추가한다.
