lemon56789/delta_robot_proj/docs/member_profiles/L.md

# L Profile

## Role
시스템 통합, 가상센싱 담당.

## AI Prompt Seed
L은 시스템 통합과 가상센싱 관점에서 답변을 원한다. 제어 흐름, 데이터 계약, 시뮬레이션과 실측의 연결 구조를 우선해서 설명하라.

## Background
- 학부생 연구 프로그램에서 재활 로봇 시스템 제어기 관련 주제를 수행했다.
- 해당 연구에서 PyTorch로 신경망을 구현하고 지도학습을 진행한 경험이 있다.
- 진동동역학실습에서는 Arduino 프로그래밍, 하드웨어 제작, 회로 연결을 맡았다.
- 소프트웨어학과를 복수전공 중이다.
- 제어공학, 시뮬레이션, 디지털 트윈 관련 주제를 선호한다.
- 기계요소설계, 기구학, 열전달, 열전달 및 열유체실습을 수강하지 않아 관련 주제는 상대적으로 약할 수 있다.

## Scope
- 실측 데이터와 시뮬레이션 데이터 연계
- 가상 센서 입력과 출력 정의 및 모델 설계
- 보정값을 제어 흐름에 연결하는 시스템 통합
- 소프트웨어 구성 요소와 제어 흐름 간 인터페이스 정리

## Primary Directories
- `virtual_sensor/`
- `control/`
- `data/`
- `hardware/`
- `docs/`

## Tools
- Python
- PyTorch
- Arduino
- MATLAB
- Simscape

## Strengths
- 제어 시스템과 신경망 기반 학습 경험을 함께 보유
- 실측 데이터, 시뮬레이션, 디지털 트윈 연결에 적합한 배경
- 하드웨어 제작 및 회로 연결 경험이 있어 소프트웨어와 실기기 사이의 연결 이해도가 높음

## Weaknesses Or Cautions
- 기계요소설계, 기구학, 열전달, 열전달 및 열유체실습 관련 세부 주제는 상대적으로 약할 수 있다.
- 기구 설계나 열유체 해석이 핵심인 질문은 별도 검토가 필요할 수 있다.

## Preferred Topics
- 제어공학 관련 주제
- 시뮬레이션 및 디지털 트윈 관련 주제
- 로봇 시스템 통합 주제
- 가상 센싱 및 학습 기반 보정 주제

## Common AI Support Needs
- 가상 센서 모델 구조 설계
- 데이터셋 정리 및 전처리 기준 수립
- 실측과 시뮬레이션 정합 전략 검토
- 보정값 적용 방식 정리
- 제어기와 학습 모델 사이의 인터페이스 설계

## Response Priorities
1. 모델 입력과 출력, 데이터 계약을 먼저 명확히 한다.
2. 실측 데이터, 시뮬레이션 데이터, 보정값의 연결 구조를 분명히 설명한다.
3. 제어 흐름과 학습 모델의 역할 분담을 구체적으로 구분한다.
4. 재현성 확보를 위해 실행 조건과 검증 방법을 함께 제시한다.

## Related Documents
- `fulltext.md`
- `README.md`
- `AGENTS.md`
