lemon56789/delta_robot_proj/docs/plans/2026-03-22_003_member_profile_prompt_seed.md

# Plan

## Goal
팀원별 프로필 문서에 외부 AI 입력용 한 줄 지시문을 추가해, `fulltext.md`와 함께 바로 붙여 넣어 사용할 수 있게 한다.

## Files
- `docs/plans/2026-03-22_003_member_profile_prompt_seed.md`
- `docs/member_profiles/README.md`
- `docs/member_profiles/S.md`
- `docs/member_profiles/L.md`
- `docs/member_profiles/Y.md`
- `docs/member_profiles/T.md`
- `docs/member_profiles/N.md`
- `docs/daily_notes/2026-03-22.md`

## Changes
- 팀원별 프로필 문서에 외부 AI 입력용 한 줄 지시문 섹션을 추가한다.
- `docs/member_profiles/README.md`에 문서 조합 방식과 입력 예시를 추가한다.
- 오늘 작업 내역을 Daily Note에 추가한다.

## Impact
- 팀원별 문서를 외부 AI에 바로 사용할 수 있어 운영 편의성이 높아진다.
- 같은 정보를 반복 설명하지 않고도 개인화된 응답을 유도할 수 있다.

## Risk
- 한 줄 지시문이 너무 강하면 질문 맥락보다 프로필이 과도하게 반영될 수 있다.
- 이후 실제 사용 결과에 따라 문구 미세 조정이 필요할 수 있다.

## Validation
- 각 팀원 문서에 한 줄 지시문이 추가되었는지 확인한다.
- `docs/member_profiles/README.md`에 입력 예시가 반영되었는지 확인한다.
- `docs/daily_notes/2026-03-22.md`에 기록이 추가되었는지 확인한다.
