lemon56789/delta_robot_proj/docs/plans/2026-05-04_011_note_next_simulink_simscape_step.md

# Plan

## Goal
다음 우선순위 작업이 `Simulink/Simscape` 기반 simulation path 구현이라는 점을 `docs/daily_notes/2026-05-04.md`에 기록한다.

## Files
- `docs/daily_notes/2026-05-04.md`

## Changes
- 새로운 entry를 추가해 다음 작업이 `Simulink/Simscape` 쪽이라는 점을 명시한다.
- 현재 이유를 함께 적는다:
  - SoT 기준 primary simulation source가 `Simscape`로 정의되어 있음
  - virtual sensor 학습 전에 real/sim 비교용 simulation data path를 먼저 갖추는 것이 우선순위상 자연스러움

## Impact
- 오늘 작업 종료 시점의 다음 우선순위가 Daily Note에 남는다.
- 코드나 데이터 계약은 변경하지 않는다.

## Risk
- 단순 우선순위 메모라 기능적 리스크는 없다.
- 이후 실제 Stage 4 구현 계획이 달라지면 후속 Daily Note에서 갱신이 필요하다.

## Validation
- Daily Note에 해당 entry가 추가되었는지 확인한다.
- entry 내용이 현재 SoT와 충돌하지 않는지 확인한다.
