lemon56789/delta_robot_proj/data/real/derived/measured_position_2026-06-05_run01_pre_cross_pm40_r01.csv

run_id | time | measured_x_est | measured_y_est | measured_z_est | estimator_method | valid
2026-06-05_run01_pre_cross_pm40_r01 | 16 | 0 | -1.65436122511e-24 | -263.277315147 | fk_theta_meas_command_echo_no_encoder | True
2026-06-05_run01_pre_cross_pm40_r01 | 125 | -1.32068670886e-15 | 1.33760554502e-15 | -263.277315147 | fk_theta_meas_command_echo_no_encoder | True
2026-06-05_run01_pre_cross_pm40_r01 | 219 | -2.459627542e-15 | 2.49113693411e-15 | -263.277315147 | fk_theta_meas_command_echo_no_encoder | True
2026-06-05_run01_pre_cross_pm40_r01 | 328 | -3.78031424921e-15 | 3.82874247748e-15 | -263.277315147 | fk_theta_meas_command_echo_no_encoder | True
2026-06-05_run01_pre_cross_pm40_r01 | 422 | -4.9192550807e-15 | 4.98227386492e-15 | -263.277315147 | fk_theta_meas_command_echo_no_encoder | True
2026-06-05_run01_pre_cross_pm40_r01 | 532 | -6.25205818138e-15 | 6.33215102044e-15 | -263.277315147 | fk_theta_meas_command_echo_no_encoder | True
2026-06-05_run01_pre_cross_pm40_r01 | 625 | -7.37888262104e-15 | 7.47341079738e-15 | -263.277315149 | fk_theta_meas_command_echo_no_encoder | True
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
