lemon56789/delta_robot_proj/data/real/derived/measured_position_2026-06-05_run01_pre_square_pm40_r01.csv

run_id | time | measured_x_est | measured_y_est | measured_z_est | estimator_method | valid
2026-06-05_run01_pre_square_pm40_r01 | 0 | 0 | -1.65436122511e-24 | -263.277315147 | fk_theta_meas_command_echo_no_encoder | True
2026-06-05_run01_pre_square_pm40_r01 | 109 | -7.12231147444e-16 | 2.66644748819e-15 | -263.277315147 | fk_theta_meas_command_echo_no_encoder | True
2026-06-05_run01_pre_square_pm40_r01 | 203 | -1.32644883874e-15 | 4.96595266293e-15 | -263.277315147 | fk_theta_meas_command_echo_no_encoder | True
2026-06-05_run01_pre_square_pm40_r01 | 313 | -2.04521422354e-15 | 7.65686297626e-15 | -263.277315147 | fk_theta_meas_command_echo_no_encoder | True
2026-06-05_run01_pre_square_pm40_r01 | 406 | -2.65289768079e-15 | 9.93190532833e-15 | -263.277315147 | fk_theta_meas_command_echo_no_encoder | True
2026-06-05_run01_pre_square_pm40_r01 | 531 | -3.46967652339e-15 | 1.29897579551e-14 | -263.277315148 | fk_theta_meas_command_echo_no_encoder | True
2026-06-05_run01_pre_square_pm40_r01 | 609 | -3.97934652118e-15 | 1.48978579937e-14 | -263.277315148 | fk_theta_meas_command_echo_no_encoder | True
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
