lemon56789/delta_robot_proj/data/real/derived/measured_position_2026-06-05_run01_pre_static_center_r01.csv

run_id | time | measured_x_est | measured_y_est | measured_z_est | estimator_method | valid
2026-06-05_run01_pre_static_center_r01 | 16 | 0 | -1.65436122511e-24 | -263.277315147 | fk_theta_meas_command_echo_no_encoder | True
2026-06-05_run01_pre_static_center_r01 | 125 | 4.55324039317e-15 | 8.73917744656e-15 | -263.277315147 | fk_theta_meas_command_echo_no_encoder | True
2026-06-05_run01_pre_static_center_r01 | 219 | 8.47988806859e-15 | -1.74507285811e-14 | -263.277315147 | fk_theta_meas_command_echo_no_encoder | True
2026-06-05_run01_pre_static_center_r01 | 344 | 1.37014940238e-14 | -7.42873609566e-15 | -263.277315147 | fk_theta_meas_command_echo_no_encoder | True
2026-06-05_run01_pre_static_center_r01 | 422 | 1.69597761372e-14 | 3.25514315899e-14 | -263.277315149 | fk_theta_meas_command_echo_no_encoder | True
2026-06-05_run01_pre_static_center_r01 | 531 | 2.15130165287e-14 | 4.12906090365e-14 | -263.277315148 | fk_theta_meas_command_echo_no_encoder | True
2026-06-05_run01_pre_static_center_r01 | 625 | 2.41673971473e-14 | 4.74271131421e-14 | -263.277315147 | fk_theta_meas_command_echo_no_encoder | True
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
