lemon56789/delta_robot_proj/data/real/derived/measured_position_2026-06-06_run01_holdout_circle_r40_r01.csv

run_id | time | measured_x_est | measured_y_est | measured_z_est | estimator_method | valid
2026-06-06_run01_holdout_circle_r40_r01 | 16 | 0 | -1.65436122511e-24 | -263.277315147 | fk_theta_meas_command_echo_no_encoder | True
2026-06-06_run01_holdout_circle_r40_r01 | 17 | 39.5097556094 | -1.49074372108 | -263.305902685 | fk_theta_meas_command_echo_no_encoder | True
2026-06-06_run01_holdout_circle_r40_r01 | 18 | 39.3435460712 | 3.8708665253 | -262.550535484 | fk_theta_meas_command_echo_no_encoder | True
2026-06-06_run01_holdout_circle_r40_r01 | 125 | 39.3435460712 | 3.8708665253 | -262.550535484 | fk_theta_meas_command_echo_no_encoder | True
2026-06-06_run01_holdout_circle_r40_r01 | 219 | 39.3435460713 | 3.87086652531 | -262.550535484 | fk_theta_meas_command_echo_no_encoder | True
2026-06-06_run01_holdout_circle_r40_r01 | 360 | 39.3435460712 | 3.8708665253 | -262.550535484 | fk_theta_meas_command_echo_no_encoder | True
2026-06-06_run01_holdout_circle_r40_r01 | 422 | 39.3435460712 | 3.8708665253 | -262.550535484 | fk_theta_meas_command_echo_no_encoder | True
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
