lemon56789/delta_robot_proj/data/real/derived/measured_position_2026-06-06_run01_holdout_cross_pm30_r01.csv

run_id | time | measured_x_est | measured_y_est | measured_z_est | estimator_method | valid
2026-06-06_run01_holdout_cross_pm30_r01 | 0 | 0 | -1.65436122511e-24 | -263.277315147 | fk_theta_meas_command_echo_no_encoder | True
2026-06-06_run01_holdout_cross_pm30_r01 | 110 | -1.33280310068e-15 | 1.34987715552e-15 | -263.277315147 | fk_theta_meas_command_echo_no_encoder | True
2026-06-06_run01_holdout_cross_pm30_r01 | 203 | -2.459627542e-15 | 2.49113693411e-15 | -263.277315147 | fk_theta_meas_command_echo_no_encoder | True
2026-06-06_run01_holdout_cross_pm30_r01 | 313 | -3.79243064103e-15 | 3.84101408798e-15 | -263.277315147 | fk_theta_meas_command_echo_no_encoder | True
2026-06-06_run01_holdout_cross_pm30_r01 | 406 | -4.9192550807e-15 | 4.98227386492e-15 | -263.277315147 | fk_theta_meas_command_echo_no_encoder | True
2026-06-06_run01_holdout_cross_pm30_r01 | 516 | -6.25205818138e-15 | 6.33215102044e-15 | -263.277315147 | fk_theta_meas_command_echo_no_encoder | True
2026-06-06_run01_holdout_cross_pm30_r01 | 610 | -7.39099901287e-15 | 7.48568240789e-15 | -263.277315149 | fk_theta_meas_command_echo_no_encoder | True
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
