lemon56789/delta_robot_proj/data/real/derived/measured_position_2026-06-06_run01_holdout_grid_3x3_pm40_r01.csv

run_id | time | measured_x_est | measured_y_est | measured_z_est | estimator_method | valid
2026-06-06_run01_holdout_grid_3x3_pm40_r01 | 0 | 0 | -1.65436122511e-24 | -263.277315147 | fk_theta_meas_command_echo_no_encoder | True
2026-06-06_run01_holdout_grid_3x3_pm40_r01 | 110 | -1.876767316e-15 | 2.31498504379e-15 | -263.277315147 | fk_theta_meas_command_echo_no_encoder | True
2026-06-06_run01_holdout_grid_3x3_pm40_r01 | 203 | -3.46348877738e-15 | 4.27219967172e-15 | -263.277315147 | fk_theta_meas_command_echo_no_encoder | True
2026-06-06_run01_holdout_grid_3x3_pm40_r01 | 313 | -5.34025609173e-15 | 6.58718471716e-15 | -263.277315147 | fk_theta_meas_command_echo_no_encoder | True
2026-06-06_run01_holdout_grid_3x3_pm40_r01 | 406 | -6.92697754981e-15 | 8.54439934426e-15 | -263.277315147 | fk_theta_meas_command_echo_no_encoder | True
2026-06-06_run01_holdout_grid_3x3_pm40_r01 | 516 | 2.04042127434e-14 | -6.00383779998e-15 | -263.277315147 | fk_theta_meas_command_echo_no_encoder | True
2026-06-06_run01_holdout_grid_3x3_pm40_r01 | 610 | 1.88004297626e-14 | -4.02557785182e-15 | -263.277315147 | fk_theta_meas_command_echo_no_encoder | True
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
