lemon56789/delta_robot_proj/experiments/figures/run01_expected_improvement_by_trajectory.png

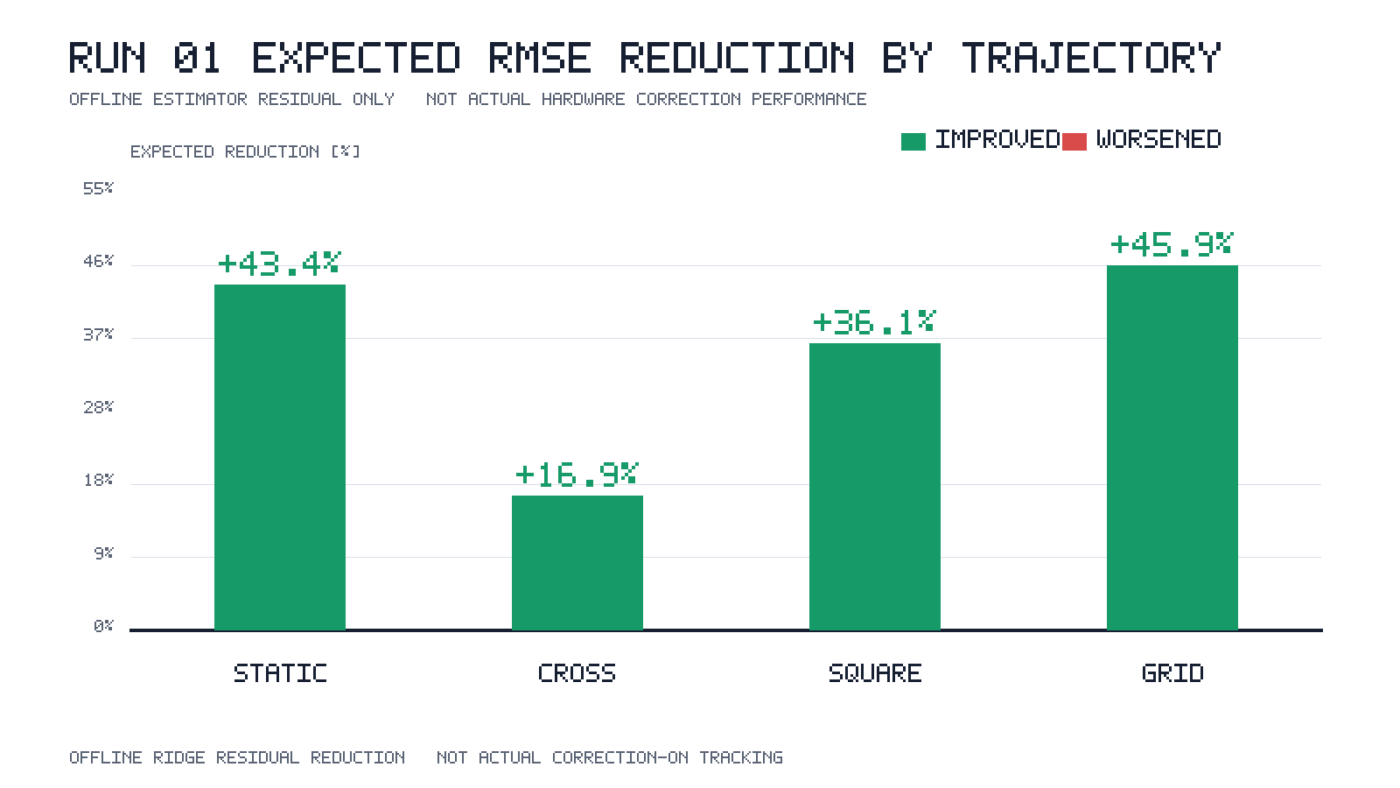
experiments/figures/run01_expected_improvement_by_trajectory.png
