lemon56789/delta_robot_proj/experiments/figures/run01_holdout_rmse_by_trajectory.png

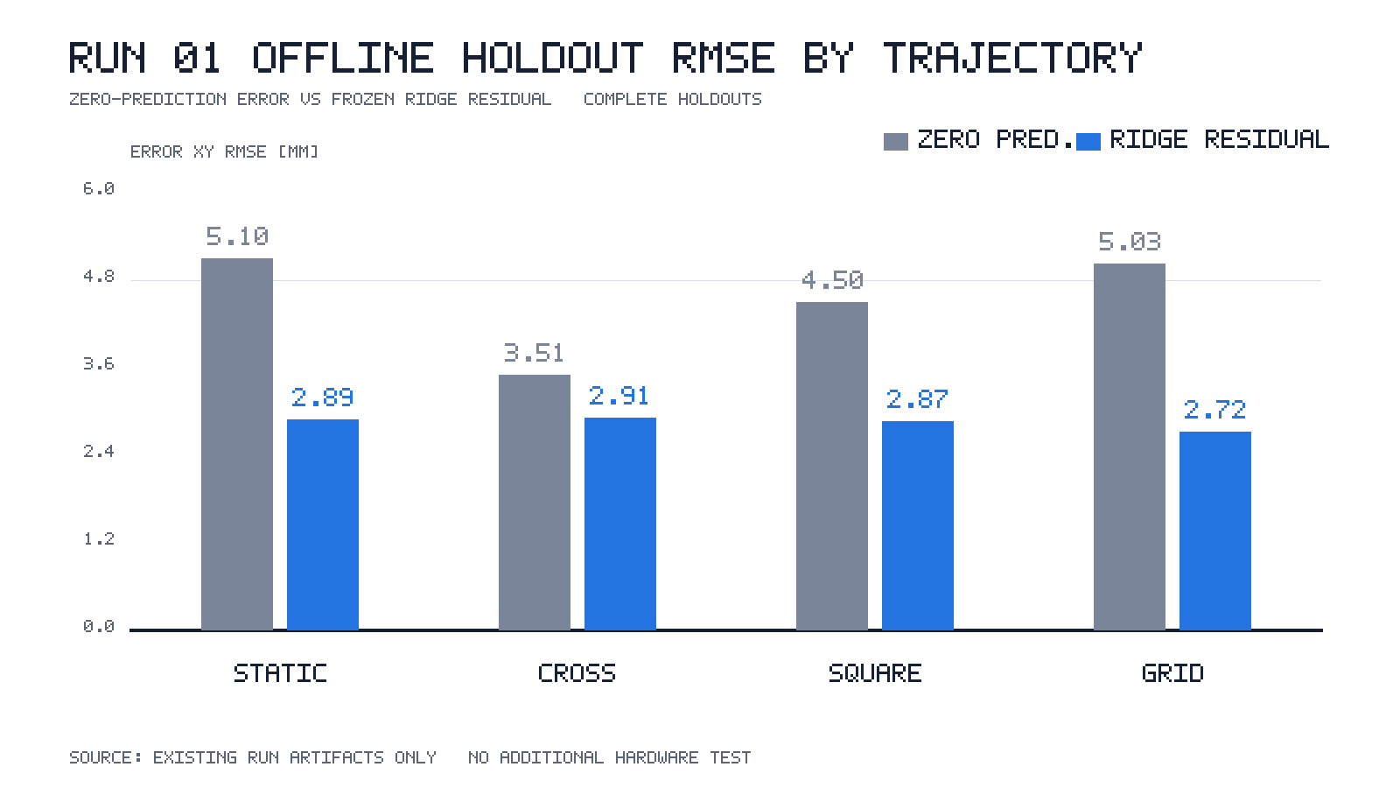
experiments/figures/run01_holdout_rmse_by_trajectory.png
