lemon56789/delta_robot_proj/experiments/figures/run02_absolute_vs_home_normalized.png

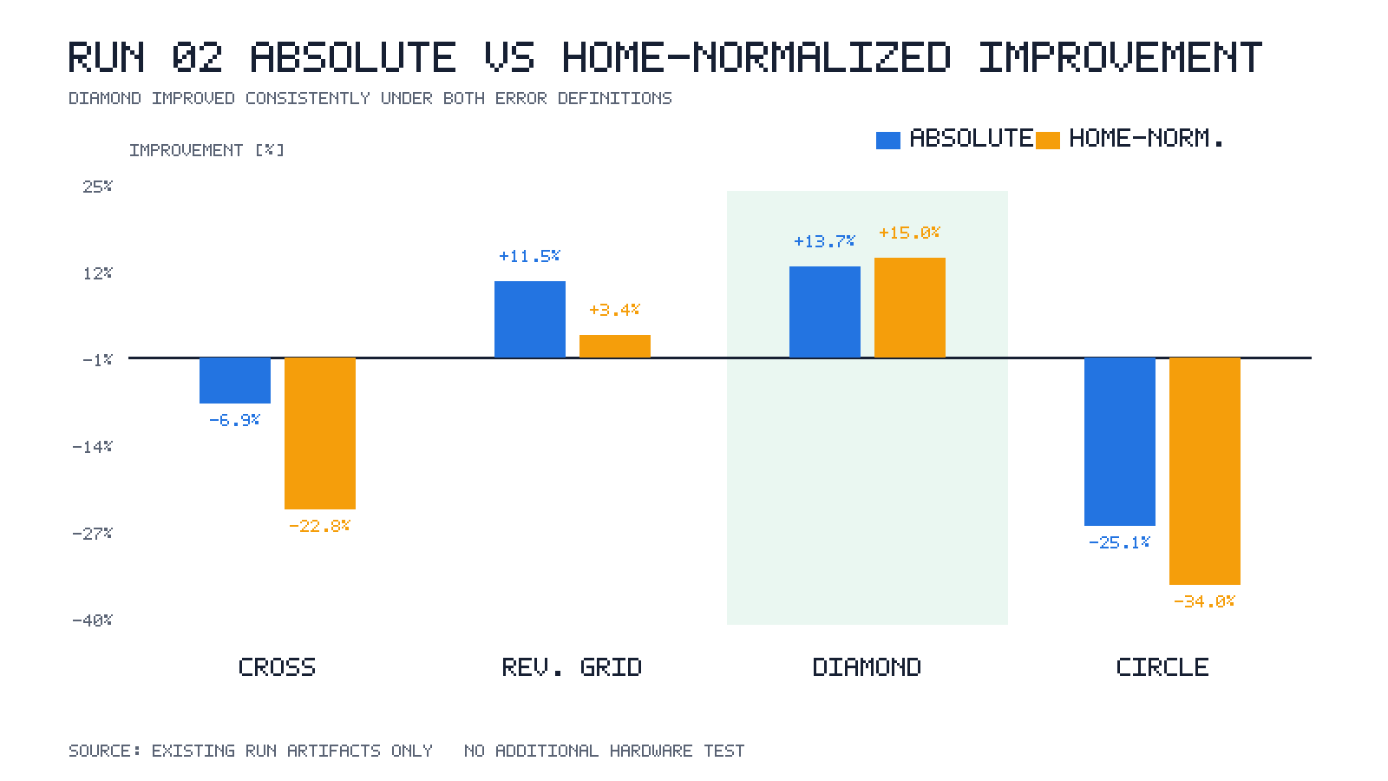
experiments/figures/run02_absolute_vs_home_normalized.png
