lemon56789/delta_robot_proj/experiments/figures/run02_actuator_command_change_rate.png

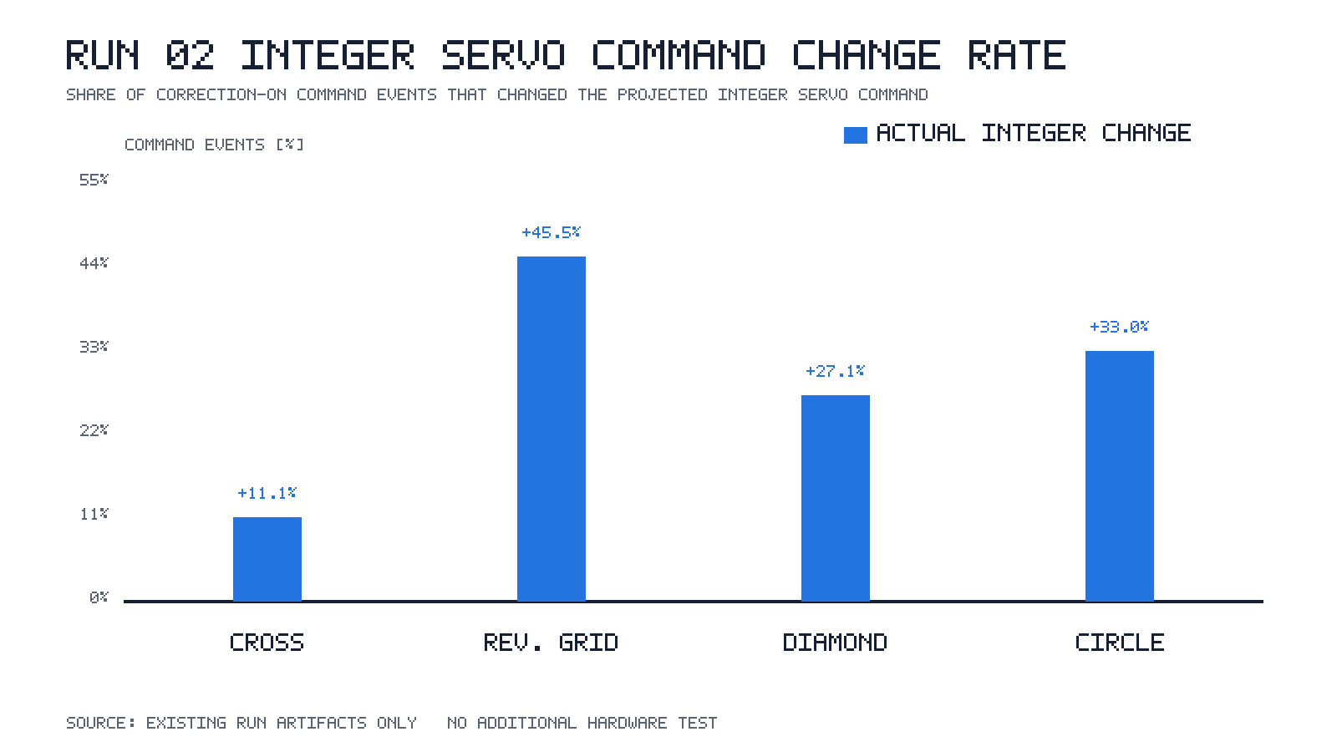
experiments/figures/run02_actuator_command_change_rate.png
