lemon56789/delta_robot_proj/experiments/figures/run02_circle_error_decomposition.png

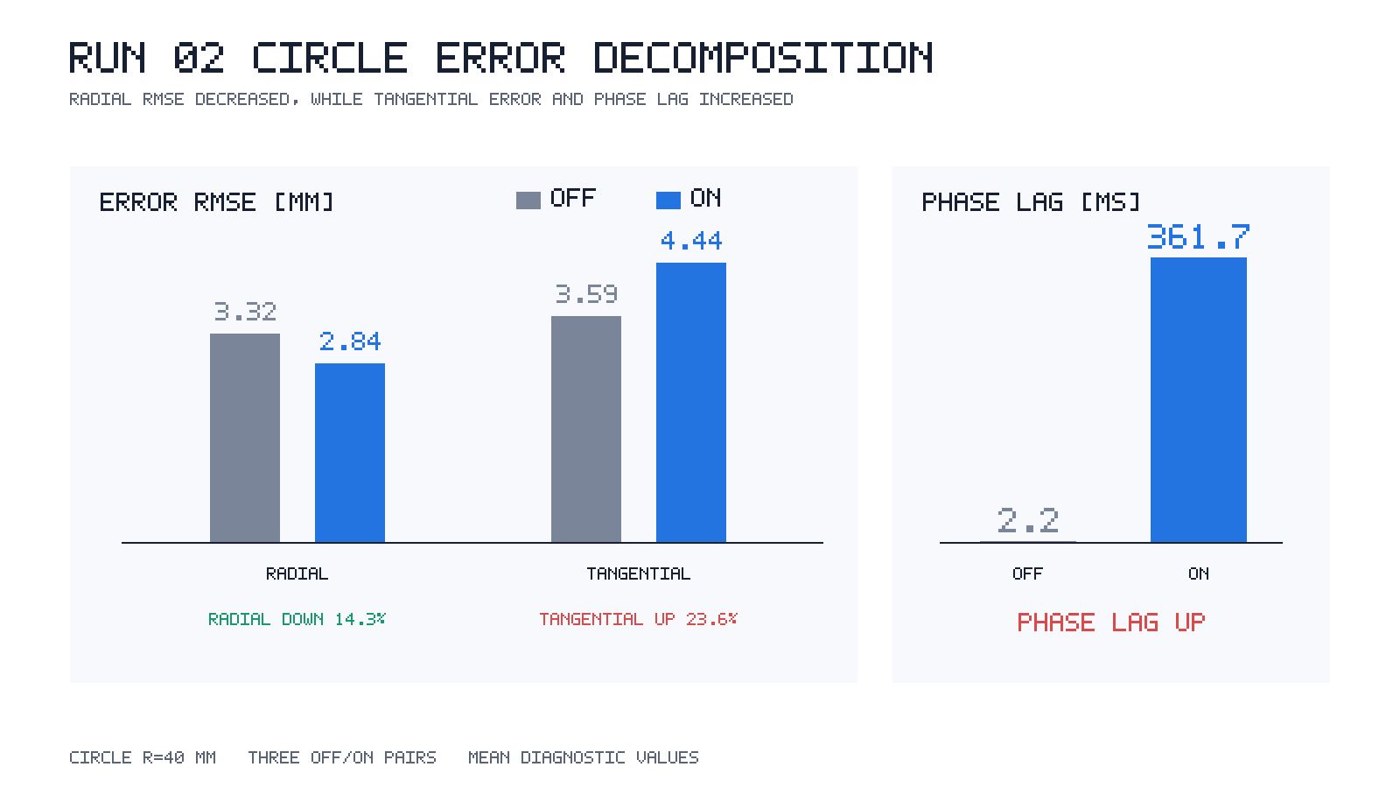
experiments/figures/run02_circle_error_decomposition.png
