lemon56789/delta_robot_proj/experiments/figures/run02_improvement_by_trajectory.png

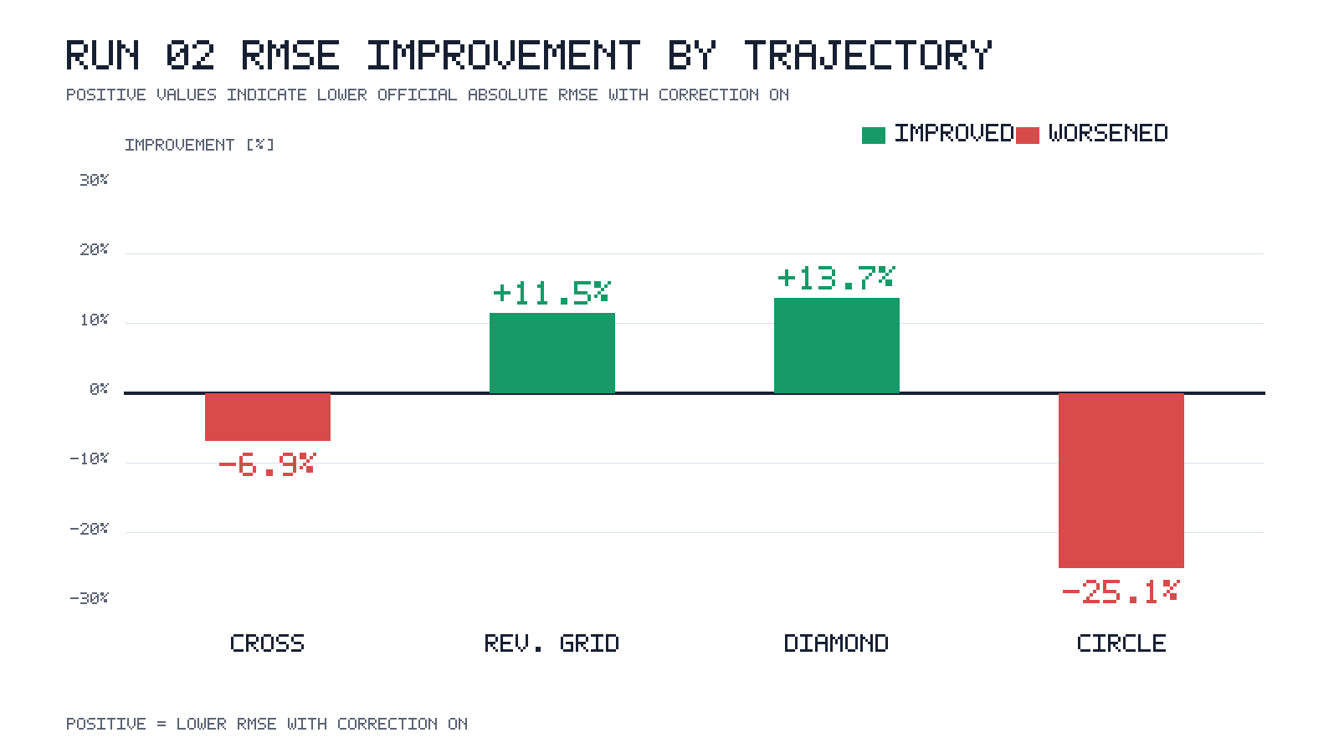
experiments/figures/run02_improvement_by_trajectory.png
