lemon56789/delta_robot_proj/docs/plans/2026-06-05_003_record_presentation_success_criteria_todo.md

# Plan

## Goal
6/8 발표 전 일정의 성공 기준과 to-do list를 daily note에 기록한다.

## Files
- `docs/plans/2026-06-05_003_record_presentation_success_criteria_todo.md`
- `docs/daily_notes/2026-06-05.md`

## Changes
- 6/8 발표 전 must-have와 nice-to-have 성공 기준을 구분한다.
- 6/5, 6/6, 6/7 일정별 to-do list를 기록한다.
- Run 02 향상이 없을 때의 fallback 발표 방향을 기록한다.
- Run 03 platform 교체는 demo-only이며 정량 비교 조건과 분리해야 함을 기록한다.

## Impact
- 문서 기록만 추가한다.
- 실험 문서, 코드, CSV 계약은 변경하지 않는다.

## Risk
- 일정이 공격적이므로 Run 02 향상 확인과 Run 03 demo는 nice-to-have로 관리한다.

## Validation
- daily note에서 보고 가능한 성공 기준과 날짜별 작업 목록이 확인되는지 검토한다.
