lemon56789/delta_robot_proj/(commit log)

2026-03-26 system data flow 문서 v0.1 draft 작성
2026-03-26 README.md 그림 추가시도
2026-04-09 IK 구현 준비 및 로드맵 작성
2026-05-03 파라미터 등록, FK 구현, IK-FK 왕복 검증 시스템 구현, workspace sweep 확인 시스템 구현
    [theta_min_sweep_z260_band_2026-05-04.csv, workspace_sweep_default_2026-05-04.csv, workspace_sweep_z260_band_2026-05-04.csv, workspace_sweep_z260_band_diagnosed_2026-05-04.csv]
2026-05-03 fake pipeline 구현
    [fake_pipeline_sample_2026-05-04.csv]
2026-05-11 workspace 계산 문서 추가 & + SoT 일부 변경
2026-05-27 IK-FK 수정
    [fake_pipeline_sample_2026-05-04_recomputed.csv, fake_pipeline_sample_2026-05-04_recomputed_simscape.csv, fake_pipeline_sample_2026-05-25_positive_theta.csv, fake_pipeline_sample_2026-05-25_positive_theta_simscape.csv]
2026-05-27 simulation 파일 사본 추가
2026-05-28 Create control test code
    델타로봇 모터, 밸브, 펌프 제어 코드(구동 테스트용으로만 작성됨)
    이 후 수정 필요.
2026-05-28 데이터 구조 일부 정리
2026-05-28 Rename control test code to motor_test.ino
2026-06-01 Update motor_test.ino
    입력각도를 합의된 기구학 기준으로 바꿈. (모터 센터 90도 --> 0도)
2026-06-04 실험 계획서 작성
    [fake_pipeline_sample_2026-05-04.csv, fake_pipeline_sample_2026-05-04_recomputed.csv, fake_pipeline_sample_2026-06-01_wb46_positive_theta.csv, fake_pipeline_sample_2026-06-01_wb46_positive_theta_simscape.csv, workspace_sweep_default_wb46_2026-06-01.csv]
2026-06-05 남은일정 plan 작성 및 00 일부 진행
    [vision_pixel_2026-06-04_run00_cpre_001.csv, vision_stopcheck_2026-06-04_run00_c_stopcheck_001.csv]
2026-06-05 컴퓨터 2 전달용 문서 제작
    [vision_stopcheck_2026-06-04_run00_c_stopcheck_001.csv]
2026-06-05 data structure update
    [vision_2026-06-05_run01_pre_static_center_r01.csv]
2026-06-05 run01-pre 완료, 일부문서 업데이트
    [measured_position_2026-06-05_run01_pre_cross_pm40_r01.csv, measured_position_2026-06-05_run01_pre_square_pm40_r01.csv, measured_position_2026-06-05_run01_pre_static_center_r01.csv, merged_2026-06-05_run01_pre_cross_pm40_r01.csv, merged_2026-06-05_run01_pre_square_pm40_r01.csv, merged_2026-06-05_run01_pre_static_center_r01.csv, simscape_2026-06-05_run01_pre_cross_pm40_r01.csv, simscape_2026-06-05_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]
2026-06-06 가상센싱용 모델 학습 완료 및 run02 준비
    [measured_position_2026-06-06_run01_holdout_cross_pm30_r01.csv, measured_position_2026-06-06_run01_holdout_grid_3x3_pm40_r01.csv, measured_position_2026-06-06_run01_holdout_square_pm30_r01.csv, measured_position_2026-06-06_run01_holdout_static_center_hold_r01.csv, measured_position_2026-06-06_run01_main_circle_r40_r01.csv, measured_position_2026-06-06_run01_main_circle_r40_r02.csv, measured_positi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]
2026-06-06 run02 com2 전달용
    [measured_position_2026-06-06_run01_holdout_circle_r40_r01.csv, merged_2026-06-06_run01_holdout_circle_r40_r01.csv, simscape_2026-06-06_run01_holdout_circle_r40_r01.csv, vision_2026-06-06_run01_holdout_circle_r40_r01.csv]
2026-06-06 run02 csv simscape 처리 완료
    [main_schedule_circle_r40.csv, main_schedule_cross_pm30.csv, main_schedule_diamond_pm35.csv, main_schedule_reverse_grid_3x3_pm40.csv, simscape_run02_nominal_circle_r40.csv, simscape_run02_nominal_cross_pm30.csv, simscape_run02_nominal_diamond_pm35.csv, simscape_run02_nominal_reverse_grid_3x3_pm40.csv]
2026-06-07 Update and rename motor_test.ino to motor_test_IK.ino
2026-06-07 run02 분석용 추가 실험
    [measured_position_2026-06-06_run02_circle_r40_off_r01.csv, measured_position_2026-06-06_run02_circle_r40_off_r02.csv, measured_position_2026-06-06_run02_circle_r40_off_r03.csv, measured_position_2026-06-06_run02_circle_r40_on_r01.csv, measured_position_2026-06-06_run02_circle_r40_on_r02.csv, measured_position_2026-06-06_run02_circle_r40_on_r03.csv, measured_position_2026-06-06_run02_cross_pm30_of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]
2026-06-07 발표자료
    [run01_presentation_summary_2026-06-07.csv, run02_presentation_summary_2026-06-07.csv]
